OuyangJunyuan/Bus_Adaptor-PCB/BusAdaptor_v2.0/doc/射频参考布线图.jpg

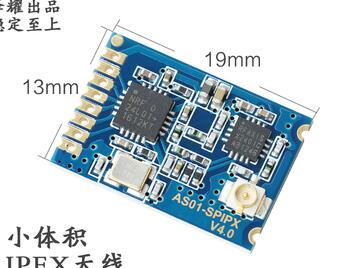
BusAdaptor_v2.0/doc/射频参考布线图.jpg
