OuyangJunyuan/Bus_Adaptor-PCB/BusAdaptor_v2.0/Bus_Adaptor_Sw/backup/pcbpindesign/MDK-ARM/pcbpindesign/pcbpindesign.htm

# Static Call Graph for image pcbpindesign\pcbpindesign.axf

#<CALLGRAPH># ARM Linker, 5060750: Last Updated: Wed Jul 29 13:44:23 2020

### Maximum Stack Usage = 232 bytes + Unknown(Cycles, Untraceable Function Pointers)

### Call chain for Maximum Stack Depth:

OTG_HS_IRQHandler ⇒ HAL_PCD_IRQHandler ⇒ HAL_PCDEx_LPM_Callback ⇒ SystemClock_Config ⇒ HAL_RCC_ClockConfig ⇒ HAL_RCC_GetSysClockFreq ⇒ __aeabi_uldivmod

### Mutually Recursive functions

- ADC_IRQHandler ⇒ ADC_IRQHandler
- BusFault_Handler ⇒ BusFault_Handler
- HardFault_Handler ⇒ HardFault_Handler
- MemManage_Handler ⇒ MemManage_Handler
- UsageFault_Handler ⇒ UsageFault_Handler

### Function Pointers

- ADC_IRQHandler from startup_stm32f765xx.o(.text) referenced from startup_stm32f765xx.o(RESET)
- BusFault_Handler from stm32f7xx_it.o(i.BusFault_Handler) referenced from startup_stm32f765xx.o(RESET)
- CAN1_RX0_IRQHandler from startup_stm32f765xx.o(.text) referenced from startup_stm32f765xx.o(RESET)
- CAN1_RX1_IRQHandler from startup_stm32f765xx.o(.text) referenced from startup_stm32f765xx.o(RESET)
- CAN1_SCE_IRQHandler from startup_stm32f765xx.o(.text) referenced from startup_stm32f765xx.o(RESET)
- CAN1_TX_IRQHandler from startup_stm32f765xx.o(.text) referenced from startup_stm32f765xx.o(RESET)
- CAN2_RX0_IRQHandler from startup_stm32f765xx.o(.text) referenced from startup_stm32f765xx.o(RESET)
- CAN2_RX1_IRQHandler from startup_stm32f765xx.o(.text) referenced from startup_stm32f765xx.o(RESET)
- CAN2_SCE_IRQHandler from startup_stm32f765xx.o(.text) referenced from startup_stm32f765xx.o(RESET)
- CAN2_TX_IRQHandler from startup_stm32f765xx.o(.text) referenced from startup_stm32f765xx.o(RESET)
- CAN3_RX0_IRQHandler from startup_stm32f765xx.o(.text) referenced from startup_stm32f765xx.o(RESET)
- CAN3_RX1_IRQHandler from startup_stm32f765xx.o(.text) referenced from startup_stm32f765xx.o(RESET)
- CAN3_SCE_IRQHandler from startup_stm32f765xx.o(.text) referenced from startup_stm32f765xx.o(RESET)
- CAN3_TX_IRQHandler from startup_stm32f765xx.o(.text) referenced from startup_stm32f765xx.o(RESET)
- CDC_Control_HS from usbd_cdc_if.o(i.CDC_Control_HS) referenced 2 times from usbd_cdc_if.o(.data)
- CDC_DeInit_HS from usbd_cdc_if.o(i.CDC_DeInit_HS) referenced 2 times from usbd_cdc_if.o(.data)
- CDC_Init_HS from usbd_cdc_if.o(i.CDC_Init_HS) referenced 2 times from usbd_cdc_if.o(.data)
- CDC_Receive_HS from usbd_cdc_if.o(i.CDC_Receive_HS) referenced 2 times from usbd_cdc_if.o(.data)
- CDC_TransmitCplt_HS from usbd_cdc_if.o(i.CDC_TransmitCplt_HS) referenced 2 times from usbd_cdc_if.o(.data)
- CEC_IRQHandler from startup_stm32f765xx.o(.text) referenced from startup_stm32f765xx.o(RESET)
- DCMI_IRQHandler from startup_stm32f765xx.o(.text) referenced from startup_stm32f765xx.o(RESET)
- DFSDM1_FLT0_IRQHandler from startup_stm32f765xx.o(.text) referenced from startup_stm32f765xx.o(RESET)
- DFSDM1_FLT1_IRQHandler from startup_stm32f765xx.o(.text) referenced from startup_stm32f765xx.o(RESET)
- DFSDM1_FLT2_IRQHandler from startup_stm32f765xx.o(.text) referenced from startup_stm32f765xx.o(RESET)
- DFSDM1_FLT3_IRQHandler from startup_stm32f765xx.o(.text) referenced from startup_stm32f765xx.o(RESET)
- DMA1_Stream0_IRQHandler from startup_stm32f765xx.o(.text) referenced from startup_stm32f765xx.o(RESET)
- DMA1_Stream1_IRQHandler from startup_stm32f765xx.o(.text) referenced from startup_stm32f765xx.o(RESET)
- DMA1_Stream2_IRQHandler from startup_stm32f765xx.o(.text) referenced from startup_stm32f765xx.o(RESET)
- DMA1_Stream3_IRQHandler from startup_stm32f765xx.o(.text) referenced from startup_stm32f765xx.o(RESET)
- DMA1_Stream4_IRQHandler from startup_stm32f765xx.o(.text) referenced from startup_stm32f765xx.o(RESET)
- DMA1_Stream5_IRQHandler from startup_stm32f765xx.o(.text) referenced from startup_stm32f765xx.o(RESET)
- DMA1_Stream6_IRQHandler from startup_stm32f765xx.o(.text) referenced from startup_stm32f765xx.o(RESET)
- DMA1_Stream7_IRQHandler from startup_stm32f765xx.o(.text) referenced from startup_stm32f765xx.o(RESET)
- DMA2D_IRQHandler from startup_stm32f765xx.o(.text) referenced from startup_stm32f765xx.o(RESET)
- DMA2_Stream0_IRQHandler from startup_stm32f765xx.o(.text) referenced from startup_stm32f765xx.o(RESET)
- DMA2_Stream1_IRQHandler from startup_stm32f765xx.o(.text) referenced from startup_stm32f765xx.o(RESET)
- DMA2_Stream2_IRQHandler from startup_stm32f765xx.o(.text) referenced from startup_stm32f765xx.o(RESET)
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
- TIM8_TRG_COM_TIM14_IRQHandler from startup_stm32f765xx.o(.text) referenced from startup_stm32f765xx.o(RESET)
- TIM8_UP_TIM13_IRQHandler from startup_stm32f765xx.o(.text) referenced from startup_stm32f765xx.o(RESET)
- UART4_IRQHandler from startup_stm32f765xx.o(.text) referenced from startup_stm32f765xx.o(RESET)
- UART5_IRQHandler from startup_stm32f765xx.o(.text) referenced from startup_stm32f765xx.o(RESET)
- UART7_IRQHandler from startup_stm32f765xx.o(.text) referenced from startup_stm32f765xx.o(RESET)
- UART8_IRQHandler from startup_stm32f765xx.o(.text) referenced from startup_stm32f765xx.o(RESET)
- USART1_IRQHandler from startup_stm32f765xx.o(.text) referenced from startup_stm32f765xx.o(RESET)
- USART2_IRQHandler from startup_stm32f765xx.o(.text) referenced from startup_stm32f765xx.o(RESET)
- USART3_IRQHandler from startup_stm32f765xx.o(.text) referenced from startup_stm32f765xx.o(RESET)
- USART6_IRQHandler from startup_stm32f765xx.o(.text) referenced from startup_stm32f765xx.o(RESET)
- USBD_CDC_DataIn from usbd_cdc.o(i.USBD_CDC_DataIn) referenced 2 times from usbd_cdc.o(.data)
- USBD_CDC_DataOut from usbd_cdc.o(i.USBD_CDC_DataOut) referenced 2 times from usbd_cdc.o(.data)
- USBD_CDC_DeInit from usbd_cdc.o(i.USBD_CDC_DeInit) referenced 2 times from usbd_cdc.o(.data)
- USBD_CDC_EP0_RxReady from usbd_cdc.o(i.USBD_CDC_EP0_RxReady) referenced 2 times from usbd_cdc.o(.data)
- USBD_CDC_GetDeviceQualifierDescriptor from usbd_cdc.o(i.USBD_CDC_GetDeviceQualifierDescriptor) referenced 2 times from usbd_cdc.o(.data)
- USBD_CDC_GetFSCfgDesc from usbd_cdc.o(i.USBD_CDC_GetFSCfgDesc) referenced 2 times from usbd_cdc.o(.data)
- USBD_CDC_GetHSCfgDesc from usbd_cdc.o(i.USBD_CDC_GetHSCfgDesc) referenced 2 times from usbd_cdc.o(.data)
- USBD_CDC_GetOtherSpeedCfgDesc from usbd_cdc.o(i.USBD_CDC_GetOtherSpeedCfgDesc) referenced 2 times from usbd_cdc.o(.data)
- USBD_CDC_Init from usbd_cdc.o(i.USBD_CDC_Init) referenced 2 times from usbd_cdc.o(.data)
- USBD_CDC_Setup from usbd_cdc.o(i.USBD_CDC_Setup) referenced 2 times from usbd_cdc.o(.data)
- USBD_HS_ConfigStrDescriptor from usbd_desc.o(i.USBD_HS_ConfigStrDescriptor) referenced 2 times from usbd_desc.o(.data)
- USBD_HS_DeviceDescriptor from usbd_desc.o(i.USBD_HS_DeviceDescriptor) referenced 2 times from usbd_desc.o(.data)
- USBD_HS_InterfaceStrDescriptor from usbd_desc.o(i.USBD_HS_InterfaceStrDescriptor) referenced 2 times from usbd_desc.o(.data)
- USBD_HS_LangIDStrDescriptor from usbd_desc.o(i.USBD_HS_LangIDStrDescriptor) referenced 2 times from usbd_desc.o(.data)
- USBD_HS_ManufacturerStrDescriptor from usbd_desc.o(i.USBD_HS_ManufacturerStrDescriptor) referenced 2 times from usbd_desc.o(.data)
- USBD_HS_ProductStrDescriptor from usbd_desc.o(i.USBD_HS_ProductStrDescriptor) referenced 2 times from usbd_desc.o(.data)
- USBD_HS_SerialStrDescriptor from usbd_desc.o(i.USBD_HS_SerialStrDescriptor) referenced 2 times from usbd_desc.o(.data)
- USBD_HS_USR_BOSDescriptor from usbd_desc.o(i.USBD_HS_USR_BOSDescriptor) referenced 2 times from usbd_desc.o(.data)
- UsageFault_Handler from stm32f7xx_it.o(i.UsageFault_Handler) referenced from startup_stm32f765xx.o(RESET)
- WWDG_IRQHandler from startup_stm32f765xx.o(.text) referenced from startup_stm32f765xx.o(RESET)
- __main from entry.o(.ARM.Collect$$$$00000000) referenced from startup_stm32f765xx.o(.text)
- main from main.o(i.main) referenced from entry9a.o(.ARM.Collect$$$$0000000B)

### Global Symbols

__main (Thumb, 0 bytes, Stack size unknown bytes, entry.o(.ARM.Collect$$$$00000000))
[Address Reference Count : 1]

- startup_stm32f765xx.o(.text)

_main_stk (Thumb, 0 bytes, Stack size unknown bytes, entry2.o(.ARM.Collect$$$$00000001))

_main_scatterload (Thumb, 0 bytes, Stack size unknown bytes, entry5.o(.ARM.Collect$$$$00000004))

[Calls]

- >> __scatterload

__main_after_scatterload (Thumb, 0 bytes, Stack size unknown bytes, entry5.o(.ARM.Collect$$$$00000004))

[Called By]

- >> __scatterload

_main_clock (Thumb, 0 bytes, Stack size unknown bytes, entry7b.o(.ARM.Collect$$$$00000008))

_main_cpp_init (Thumb, 0 bytes, Stack size unknown bytes, entry8b.o(.ARM.Collect$$$$0000000A))

_main_init (Thumb, 0 bytes, Stack size unknown bytes, entry9a.o(.ARM.Collect$$$$0000000B))

__rt_final_cpp (Thumb, 0 bytes, Stack size unknown bytes, entry10a.o(.ARM.Collect$$$$0000000D))

__rt_final_exit (Thumb, 0 bytes, Stack size unknown bytes, entry11a.o(.ARM.Collect$$$$0000000F))

Reset_Handler (Thumb, 8 bytes, Stack size 0 bytes, startup_stm32f765xx.o(.text))
[Address Reference Count : 1]

- startup_stm32f765xx.o(RESET)

ADC_IRQHandler (Thumb, 0 bytes, Stack size 0 bytes, startup_stm32f765xx.o(.text))

[Calls]

- >> ADC_IRQHandler

[Called By]

- >> ADC_IRQHandler

[Address Reference Count : 1]

- startup_stm32f765xx.o(RESET)

CAN1_RX0_IRQHandler (Thumb, 0 bytes, Stack size 0 bytes, startup_stm32f765xx.o(.text))
[Address Reference Count : 1]

- startup_stm32f765xx.o(RESET)

CAN1_RX1_IRQHandler (Thumb, 0 bytes, Stack size 0 bytes, startup_stm32f765xx.o(.text))
[Address Reference Count : 1]

- startup_stm32f765xx.o(RESET)

CAN1_SCE_IRQHandler (Thumb, 0 bytes, Stack size 0 bytes, startup_stm32f765xx.o(.text))
[Address Reference Count : 1]

- startup_stm32f765xx.o(RESET)

CAN1_TX_IRQHandler (Thumb, 0 bytes, Stack size 0 bytes, startup_stm32f765xx.o(.text))
[Address Reference Count : 1]

- startup_stm32f765xx.o(RESET)

CAN2_RX0_IRQHandler (Thumb, 0 bytes, Stack size 0 bytes, startup_stm32f765xx.o(.text))
[Address Reference Count : 1]

- startup_stm32f765xx.o(RESET)

CAN2_RX1_IRQHandler (Thumb, 0 bytes, Stack size 0 bytes, startup_stm32f765xx.o(.text))
[Address Reference Count : 1]

- startup_stm32f765xx.o(RESET)

CAN2_SCE_IRQHandler (Thumb, 0 bytes, Stack size 0 bytes, startup_stm32f765xx.o(.text))
[Address Reference Count : 1]

- startup_stm32f765xx.o(RESET)

CAN2_TX_IRQHandler (Thumb, 0 bytes, Stack size 0 bytes, startup_stm32f765xx.o(.text))
[Address Reference Count : 1]

- startup_stm32f765xx.o(RESET)

CAN3_RX0_IRQHandler (Thumb, 0 bytes, Stack size 0 bytes, startup_stm32f765xx.o(.text))
[Address Reference Count : 1]

- startup_stm32f765xx.o(RESET)

CAN3_RX1_IRQHandler (Thumb, 0 bytes, Stack size 0 bytes, startup_stm32f765xx.o(.text))
[Address Reference Count : 1]

- startup_stm32f765xx.o(RESET)

CAN3_SCE_IRQHandler (Thumb, 0 bytes, Stack size 0 bytes, startup_stm32f765xx.o(.text))
[Address Reference Count : 1]

- startup_stm32f765xx.o(RESET)

CAN3_TX_IRQHandler (Thumb, 0 bytes, Stack size 0 bytes, startup_stm32f765xx.o(.text))
[Address Reference Count : 1]

- startup_stm32f765xx.o(RESET)

CEC_IRQHandler (Thumb, 0 bytes, Stack size 0 bytes, startup_stm32f765xx.o(.text))
[Address Reference Count : 1]

- startup_stm32f765xx.o(RESET)

DCMI_IRQHandler (Thumb, 0 bytes, Stack size 0 bytes, startup_stm32f765xx.o(.text))
[Address Reference Count : 1]

- startup_stm32f765xx.o(RESET)

DFSDM1_FLT0_IRQHandler (Thumb, 0 bytes, Stack size 0 bytes, startup_stm32f765xx.o(.text))
[Address Reference Count : 1]

- startup_stm32f765xx.o(RESET)

DFSDM1_FLT1_IRQHandler (Thumb, 0 bytes, Stack size 0 bytes, startup_stm32f765xx.o(.text))
[Address Reference Count : 1]

- startup_stm32f765xx.o(RESET)

DFSDM1_FLT2_IRQHandler (Thumb, 0 bytes, Stack size 0 bytes, startup_stm32f765xx.o(.text))
[Address Reference Count : 1]

- startup_stm32f765xx.o(RESET)

DFSDM1_FLT3_IRQHandler (Thumb, 0 bytes, Stack size 0 bytes, startup_stm32f765xx.o(.text))
[Address Reference Count : 1]

- startup_stm32f765xx.o(RESET)

DMA1_Stream0_IRQHandler (Thumb, 0 bytes, Stack size 0 bytes, startup_stm32f765xx.o(.text))
[Address Reference Count : 1]

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

TIM4_IRQHandler (Thumb, 0 bytes, Stack size 0 bytes, startup_stm32f765xx.o(.text))
[Address Reference Count : 1]

- startup_stm32f765xx.o(RESET)

TIM5_IRQHandler (Thumb, 0 bytes, Stack size 0 bytes, startup_stm32f765xx.o(.text))
[Address Reference Count : 1]

- startup_stm32f765xx.o(RESET)

TIM6_DAC_IRQHandler (Thumb, 0 bytes, Stack size 0 bytes, startup_stm32f765xx.o(.text))
[Address Reference Count : 1]

- startup_stm32f765xx.o(RESET)

TIM7_IRQHandler (Thumb, 0 bytes, Stack size 0 bytes, startup_stm32f765xx.o(.text))
[Address Reference Count : 1]

- startup_stm32f765xx.o(RESET)

TIM8_BRK_TIM12_IRQHandler (Thumb, 0 bytes, Stack size 0 bytes, startup_stm32f765xx.o(.text))
[Address Reference Count : 1]

- startup_stm32f765xx.o(RESET)

TIM8_CC_IRQHandler (Thumb, 0 bytes, Stack size 0 bytes, startup_stm32f765xx.o(.text))
[Address Reference Count : 1]

- startup_stm32f765xx.o(RESET)

TIM8_TRG_COM_TIM14_IRQHandler (Thumb, 0 bytes, Stack size 0 bytes, startup_stm32f765xx.o(.text))
[Address Reference Count : 1]

- startup_stm32f765xx.o(RESET)

TIM8_UP_TIM13_IRQHandler (Thumb, 0 bytes, Stack size 0 bytes, startup_stm32f765xx.o(.text))
[Address Reference Count : 1]

- startup_stm32f765xx.o(RESET)

UART4_IRQHandler (Thumb, 0 bytes, Stack size 0 bytes, startup_stm32f765xx.o(.text))
[Address Reference Count : 1]

- startup_stm32f765xx.o(RESET)

UART5_IRQHandler (Thumb, 0 bytes, Stack size 0 bytes, startup_stm32f765xx.o(.text))
[Address Reference Count : 1]

- startup_stm32f765xx.o(RESET)

UART7_IRQHandler (Thumb, 0 bytes, Stack size 0 bytes, startup_stm32f765xx.o(.text))
[Address Reference Count : 1]

- startup_stm32f765xx.o(RESET)

UART8_IRQHandler (Thumb, 0 bytes, Stack size 0 bytes, startup_stm32f765xx.o(.text))
[Address Reference Count : 1]

- startup_stm32f765xx.o(RESET)

USART1_IRQHandler (Thumb, 0 bytes, Stack size 0 bytes, startup_stm32f765xx.o(.text))
[Address Reference Count : 1]

- startup_stm32f765xx.o(RESET)

USART2_IRQHandler (Thumb, 0 bytes, Stack size 0 bytes, startup_stm32f765xx.o(.text))
[Address Reference Count : 1]

- startup_stm32f765xx.o(RESET)

USART3_IRQHandler (Thumb, 0 bytes, Stack size 0 bytes, startup_stm32f765xx.o(.text))
[Address Reference Count : 1]

- startup_stm32f765xx.o(RESET)

USART6_IRQHandler (Thumb, 0 bytes, Stack size 0 bytes, startup_stm32f765xx.o(.text))
[Address Reference Count : 1]

- startup_stm32f765xx.o(RESET)

WWDG_IRQHandler (Thumb, 0 bytes, Stack size 0 bytes, startup_stm32f765xx.o(.text))
[Address Reference Count : 1]

- startup_stm32f765xx.o(RESET)

__aeabi_uldivmod (Thumb, 98 bytes, Stack size 40 bytes, uldiv.o(.text))

[Stack]

- Max Depth = 40
- Call Chain = __aeabi_uldivmod

[Calls]

- >> __aeabi_llsr
- >> __aeabi_llsl

[Called By]

- >> HAL_RCC_GetSysClockFreq

__aeabi_memcpy (Thumb, 36 bytes, Stack size 0 bytes, memcpya.o(.text), UNUSED)

__aeabi_memcpy4 (Thumb, 0 bytes, Stack size 0 bytes, memcpya.o(.text))

[Called By]

- >> HAL_PCD_Init

__aeabi_memcpy8 (Thumb, 0 bytes, Stack size 0 bytes, memcpya.o(.text), UNUSED)

__aeabi_memset (Thumb, 14 bytes, Stack size 0 bytes, memseta.o(.text), UNUSED)

[Called By]

- >> _memset$wrapper
- >> __aeabi_memclr

__aeabi_memset4 (Thumb, 0 bytes, Stack size 0 bytes, memseta.o(.text), UNUSED)

__aeabi_memset8 (Thumb, 0 bytes, Stack size 0 bytes, memseta.o(.text), UNUSED)

__aeabi_memclr (Thumb, 4 bytes, Stack size 0 bytes, memseta.o(.text), UNUSED)

[Calls]

- >> __aeabi_memset

__aeabi_memclr4 (Thumb, 0 bytes, Stack size 0 bytes, memseta.o(.text))

[Called By]

- >> HAL_PCD_MspInit
- >> SystemClock_Config

__aeabi_memclr8 (Thumb, 0 bytes, Stack size 0 bytes, memseta.o(.text), UNUSED)

_memset$wrapper (Thumb, 18 bytes, Stack size 8 bytes, memseta.o(.text), UNUSED)

[Calls]

- >> __aeabi_memset

__aeabi_llsl (Thumb, 30 bytes, Stack size 0 bytes, llshl.o(.text))

[Called By]

- >> __aeabi_uldivmod

_ll_shift_l (Thumb, 0 bytes, Stack size 0 bytes, llshl.o(.text), UNUSED)

__aeabi_llsr (Thumb, 32 bytes, Stack size 0 bytes, llushr.o(.text))

[Called By]

- >> __aeabi_uldivmod

_ll_ushift_r (Thumb, 0 bytes, Stack size 0 bytes, llushr.o(.text), UNUSED)

__scatterload (Thumb, 28 bytes, Stack size 0 bytes, init.o(.text))

[Calls]

- >> __main_after_scatterload

[Called By]

- >> _main_scatterload

__scatterload_rt2 (Thumb, 0 bytes, Stack size 0 bytes, init.o(.text), UNUSED)

__decompress (Thumb, 0 bytes, Stack size unknown bytes, __dczerorl2.o(.text), UNUSED)

__decompress1 (Thumb, 86 bytes, Stack size unknown bytes, __dczerorl2.o(.text), UNUSED)

BusFault_Handler (Thumb, 2 bytes, Stack size 0 bytes, stm32f7xx_it.o(i.BusFault_Handler))

[Calls]

- >> BusFault_Handler

[Called By]

- >> BusFault_Handler

[Address Reference Count : 1]

- startup_stm32f765xx.o(RESET)

DebugMon_Handler (Thumb, 2 bytes, Stack size 0 bytes, stm32f7xx_it.o(i.DebugMon_Handler))
[Address Reference Count : 1]

- startup_stm32f765xx.o(RESET)

Error_Handler (Thumb, 2 bytes, Stack size 0 bytes, main.o(i.Error_Handler))

[Called By]

- >> USBD_LL_Init
- >> HAL_PCD_ResetCallback
- >> MX_USB_DEVICE_Init

HAL_Delay (Thumb, 32 bytes, Stack size 16 bytes, stm32f7xx_hal.o(i.HAL_Delay))

[Stack]

- Max Depth = 16
- Call Chain = HAL_Delay

[Calls]

- >> HAL_GetTick

[Called By]

- >> USB_SetCurrentMode
- >> USB_DevDisconnect
- >> USB_DevConnect

HAL_GPIO_Init (Thumb, 420 bytes, Stack size 40 bytes, stm32f7xx_hal_gpio.o(i.HAL_GPIO_Init))

[Stack]

- Max Depth = 40
- Call Chain = HAL_GPIO_Init

[Called By]

- >> HAL_PCD_MspInit

HAL_GetTick (Thumb, 6 bytes, Stack size 0 bytes, stm32f7xx_hal.o(i.HAL_GetTick))

[Called By]

- >> HAL_Delay
- >> HAL_RCC_OscConfig
- >> HAL_RCC_ClockConfig
- >> HAL_PWREx_EnableOverDrive

HAL_IncTick (Thumb, 12 bytes, Stack size 0 bytes, stm32f7xx_hal.o(i.HAL_IncTick))

[Called By]

- >> SysTick_Handler

HAL_Init (Thumb, 22 bytes, Stack size 8 bytes, stm32f7xx_hal.o(i.HAL_Init))

[Stack]

- Max Depth = 40
- Call Chain = HAL_Init ⇒ HAL_InitTick ⇒ HAL_NVIC_SetPriority

[Calls]

- >> HAL_InitTick
- >> HAL_MspInit
- >> HAL_NVIC_SetPriorityGrouping

[Called By]

- >> main

HAL_InitTick (Thumb, 54 bytes, Stack size 16 bytes, stm32f7xx_hal.o(i.HAL_InitTick))

[Stack]

- Max Depth = 32
- Call Chain = HAL_InitTick ⇒ HAL_NVIC_SetPriority

[Calls]

- >> HAL_NVIC_SetPriority
- >> HAL_SYSTICK_Config

[Called By]

- >> HAL_RCC_ClockConfig
- >> HAL_Init

HAL_MspInit (Thumb, 42 bytes, Stack size 8 bytes, stm32f7xx_hal_msp.o(i.HAL_MspInit))

[Stack]

- Max Depth = 8
- Call Chain = HAL_MspInit

[Called By]

- >> HAL_Init

HAL_NVIC_EnableIRQ (Thumb, 26 bytes, Stack size 0 bytes, stm32f7xx_hal_cortex.o(i.HAL_NVIC_EnableIRQ))

[Called By]

- >> HAL_PCD_MspInit

HAL_NVIC_SetPriority (Thumb, 60 bytes, Stack size 16 bytes, stm32f7xx_hal_cortex.o(i.HAL_NVIC_SetPriority))

[Stack]

- Max Depth = 16
- Call Chain = HAL_NVIC_SetPriority

[Calls]

- >> __NVIC_SetPriority

[Called By]

- >> HAL_PCD_MspInit
- >> HAL_InitTick

HAL_NVIC_SetPriorityGrouping (Thumb, 28 bytes, Stack size 8 bytes, stm32f7xx_hal_cortex.o(i.HAL_NVIC_SetPriorityGrouping))

[Stack]

- Max Depth = 8
- Call Chain = HAL_NVIC_SetPriorityGrouping

[Called By]

- >> HAL_Init

HAL_PCDEx_ActivateLPM (Thumb, 34 bytes, Stack size 0 bytes, stm32f7xx_hal_pcd_ex.o(i.HAL_PCDEx_ActivateLPM))

[Called By]

- >> HAL_PCD_Init

HAL_PCDEx_LPM_Callback (Thumb, 92 bytes, Stack size 16 bytes, usbd_conf.o(i.HAL_PCDEx_LPM_Callback))

[Stack]

- Max Depth = 184
- Call Chain = HAL_PCDEx_LPM_Callback ⇒ SystemClock_Config ⇒ HAL_RCC_ClockConfig ⇒ HAL_RCC_GetSysClockFreq ⇒ __aeabi_uldivmod

[Calls]

- >> USBD_LL_Suspend
- >> USBD_LL_Resume
- >> SystemClock_Config

[Called By]

- >> HAL_PCD_IRQHandler

HAL_PCDEx_SetRxFiFo (Thumb, 8 bytes, Stack size 0 bytes, stm32f7xx_hal_pcd_ex.o(i.HAL_PCDEx_SetRxFiFo))

[Called By]

- >> USBD_LL_Init

HAL_PCDEx_SetTxFiFo (Thumb, 70 bytes, Stack size 20 bytes, stm32f7xx_hal_pcd_ex.o(i.HAL_PCDEx_SetTxFiFo))

[Stack]

- Max Depth = 20
- Call Chain = HAL_PCDEx_SetTxFiFo

[Called By]

- >> USBD_LL_Init

HAL_PCD_ConnectCallback (Thumb, 8 bytes, Stack size 0 bytes, usbd_conf.o(i.HAL_PCD_ConnectCallback))

[Calls]

- >> USBD_LL_DevConnected

[Called By]

- >> HAL_PCD_IRQHandler

HAL_PCD_DataInStageCallback (Thumb, 18 bytes, Stack size 0 bytes, usbd_conf.o(i.HAL_PCD_DataInStageCallback))

[Stack]

- Max Depth = 88
- Call Chain = HAL_PCD_DataInStageCallback ⇒ USBD_LL_DataInStage ⇒ USBD_CtlContinueSendData ⇒ USBD_LL_Transmit ⇒ HAL_PCD_EP_Transmit ⇒ USB_EPStartXfer ⇒ USB_WritePacket

[Calls]

- >> USBD_LL_DataInStage

[Called By]

- >> HAL_PCD_IRQHandler

HAL_PCD_DataOutStageCallback (Thumb, 20 bytes, Stack size 0 bytes, usbd_conf.o(i.HAL_PCD_DataOutStageCallback))

[Stack]

- Max Depth = 80
- Call Chain = HAL_PCD_DataOutStageCallback ⇒ USBD_LL_DataOutStage ⇒ USBD_CtlSendStatus ⇒ USBD_LL_Transmit ⇒ HAL_PCD_EP_Transmit ⇒ USB_EPStartXfer ⇒ USB_WritePacket

[Calls]

- >> USBD_LL_DataOutStage

[Called By]

- >> PCD_EP_OutXfrComplete_int

HAL_PCD_DisconnectCallback (Thumb, 8 bytes, Stack size 0 bytes, usbd_conf.o(i.HAL_PCD_DisconnectCallback))

[Stack]

- Max Depth = 8
- Call Chain = HAL_PCD_DisconnectCallback ⇒ USBD_LL_DevDisconnected

[Calls]

- >> USBD_LL_DevDisconnected

[Called By]

- >> HAL_PCD_IRQHandler

HAL_PCD_EP_Close (Thumb, 76 bytes, Stack size 16 bytes, stm32f7xx_hal_pcd.o(i.HAL_PCD_EP_Close))

[Stack]

- Max Depth = 32
- Call Chain = HAL_PCD_EP_Close ⇒ USB_DeactivateEndpoint

[Calls]

- >> USB_DeactivateEndpoint

[Called By]

- >> USBD_LL_CloseEP

HAL_PCD_EP_ClrStall (Thumb, 92 bytes, Stack size 16 bytes, stm32f7xx_hal_pcd.o(i.HAL_PCD_EP_ClrStall))

[Stack]

- Max Depth = 16
- Call Chain = HAL_PCD_EP_ClrStall

[Calls]

- >> USB_EPClearStall

[Called By]

- >> USBD_LL_ClearStallEP

HAL_PCD_EP_GetRxCount (Thumb, 18 bytes, Stack size 0 bytes, stm32f7xx_hal_pcd.o(i.HAL_PCD_EP_GetRxCount))

[Called By]

- >> USBD_LL_GetRxDataSize

HAL_PCD_EP_Open (Thumb, 96 bytes, Stack size 24 bytes, stm32f7xx_hal_pcd.o(i.HAL_PCD_EP_Open))

[Stack]

- Max Depth = 40
- Call Chain = HAL_PCD_EP_Open ⇒ USB_ActivateEndpoint

[Calls]

- >> USB_ActivateEndpoint

[Called By]

- >> USBD_LL_OpenEP

HAL_PCD_EP_Receive (Thumb, 68 bytes, Stack size 16 bytes, stm32f7xx_hal_pcd.o(i.HAL_PCD_EP_Receive))

[Stack]

- Max Depth = 48
- Call Chain = HAL_PCD_EP_Receive ⇒ USB_EPStartXfer ⇒ USB_WritePacket

[Calls]

- >> USB_EPStartXfer
- >> USB_EP0StartXfer

[Called By]

- >> USBD_LL_PrepareReceive

HAL_PCD_EP_SetStall (Thumb, 116 bytes, Stack size 16 bytes, stm32f7xx_hal_pcd.o(i.HAL_PCD_EP_SetStall))

[Stack]

- Max Depth = 24
- Call Chain = HAL_PCD_EP_SetStall ⇒ USB_EP0_OutStart

[Calls]

- >> USB_EPSetStall
- >> USB_EP0_OutStart

[Called By]

- >> USBD_LL_StallEP

HAL_PCD_EP_Transmit (Thumb, 68 bytes, Stack size 24 bytes, stm32f7xx_hal_pcd.o(i.HAL_PCD_EP_Transmit))

[Stack]

- Max Depth = 56
- Call Chain = HAL_PCD_EP_Transmit ⇒ USB_EPStartXfer ⇒ USB_WritePacket

[Calls]

- >> USB_EPStartXfer
- >> USB_EP0StartXfer

[Called By]

- >> USBD_LL_Transmit

HAL_PCD_IRQHandler (Thumb, 1134 bytes, Stack size 48 bytes, stm32f7xx_hal_pcd.o(i.HAL_PCD_IRQHandler))

[Stack]

- Max Depth = 232
- Call Chain = HAL_PCD_IRQHandler ⇒ HAL_PCDEx_LPM_Callback ⇒ SystemClock_Config ⇒ HAL_RCC_ClockConfig ⇒ HAL_RCC_GetSysClockFreq ⇒ __aeabi_uldivmod

[Calls]

- >> HAL_PCD_SuspendCallback
- >> HAL_PCD_SetupStageCallback
- >> HAL_PCD_SOFCallback
- >> HAL_PCD_ResumeCallback
- >> HAL_PCD_ResetCallback
- >> HAL_PCD_ISOOUTIncompleteCallback
- >> HAL_PCD_ISOINIncompleteCallback
- >> HAL_PCD_DisconnectCallback
- >> HAL_PCD_DataInStageCallback
- >> HAL_PCD_ConnectCallback
- >> HAL_PCDEx_LPM_Callback
- >> USB_SetTurnaroundTime
- >> USB_ReadPacket
- >> USB_ReadInterrupts
- >> USB_ReadDevOutEPInterrupt
- >> USB_ReadDevInEPInterrupt
- >> USB_ReadDevAllOutEpInterrupt
- >> USB_ReadDevAllInEpInterrupt
- >> USB_GetMode
- >> USB_GetDevSpeed
- >> USB_FlushTxFifo
- >> USB_EP0_OutStart
- >> USB_ActivateSetup
- >> HAL_RCC_GetHCLKFreq
- >> PCD_WriteEmptyTxFifo
- >> PCD_EP_OutXfrComplete_int

[Called By]

- >> OTG_HS_IRQHandler

HAL_PCD_ISOINIncompleteCallback (Thumb, 8 bytes, Stack size 0 bytes, usbd_conf.o(i.HAL_PCD_ISOINIncompleteCallback))

[Calls]

- >> USBD_LL_IsoINIncomplete

[Called By]

- >> HAL_PCD_IRQHandler

HAL_PCD_ISOOUTIncompleteCallback (Thumb, 8 bytes, Stack size 0 bytes, usbd_conf.o(i.HAL_PCD_ISOOUTIncompleteCallback))

[Calls]

- >> USBD_LL_IsoOUTIncomplete

[Called By]

- >> HAL_PCD_IRQHandler

HAL_PCD_Init (Thumb, 242 bytes, Stack size 64 bytes, stm32f7xx_hal_pcd.o(i.HAL_PCD_Init))

[Stack]

- Max Depth = 152
- Call Chain = HAL_PCD_Init ⇒ HAL_PCD_MspInit ⇒ HAL_GPIO_Init

[Calls]

- >> HAL_PCD_MspInit
- >> __aeabi_memcpy4
- >> USB_SetCurrentMode
- >> USB_DisableGlobalInt
- >> USB_DevInit
- >> USB_DevDisconnect
- >> USB_CoreInit
- >> HAL_PCDEx_ActivateLPM

[Called By]

- >> USBD_LL_Init

HAL_PCD_MspInit (Thumb, 182 bytes, Stack size 48 bytes, usbd_conf.o(i.HAL_PCD_MspInit))

[Stack]

- Max Depth = 88
- Call Chain = HAL_PCD_MspInit ⇒ HAL_GPIO_Init

[Calls]

- >> HAL_NVIC_SetPriority
- >> HAL_NVIC_EnableIRQ
- >> HAL_GPIO_Init
- >> __aeabi_memclr4

[Called By]

- >> HAL_PCD_Init

HAL_PCD_ResetCallback (Thumb, 44 bytes, Stack size 16 bytes, usbd_conf.o(i.HAL_PCD_ResetCallback))

[Stack]

- Max Depth = 80
- Call Chain = HAL_PCD_ResetCallback ⇒ USBD_LL_Reset ⇒ USBD_LL_OpenEP ⇒ HAL_PCD_EP_Open ⇒ USB_ActivateEndpoint

[Calls]

- >> USBD_LL_SetSpeed
- >> USBD_LL_Reset
- >> Error_Handler

[Called By]

- >> HAL_PCD_IRQHandler

HAL_PCD_ResumeCallback (Thumb, 8 bytes, Stack size 0 bytes, usbd_conf.o(i.HAL_PCD_ResumeCallback))

[Calls]

- >> USBD_LL_Resume

[Called By]

- >> HAL_PCD_IRQHandler

HAL_PCD_SOFCallback (Thumb, 8 bytes, Stack size 0 bytes, usbd_conf.o(i.HAL_PCD_SOFCallback))

[Stack]

- Max Depth = 8
- Call Chain = HAL_PCD_SOFCallback ⇒ USBD_LL_SOF

[Calls]

- >> USBD_LL_SOF

[Called By]

- >> HAL_PCD_IRQHandler

HAL_PCD_SetAddress (Thumb, 40 bytes, Stack size 8 bytes, stm32f7xx_hal_pcd.o(i.HAL_PCD_SetAddress))

[Stack]

- Max Depth = 8
- Call Chain = HAL_PCD_SetAddress

[Calls]

- >> USB_SetDevAddress

[Called By]

- >> USBD_LL_SetUSBAddress

HAL_PCD_SetupStageCallback (Thumb, 14 bytes, Stack size 0 bytes, usbd_conf.o(i.HAL_PCD_SetupStageCallback))

[Stack]

- Max Depth = 136
- Call Chain = HAL_PCD_SetupStageCallback ⇒ USBD_LL_SetupStage ⇒ USBD_StdDevReq ⇒ USBD_SetConfig ⇒ USBD_CtlSendStatus ⇒ USBD_LL_Transmit ⇒ HAL_PCD_EP_Transmit ⇒ USB_EPStartXfer ⇒ USB_WritePacket

[Calls]

- >> USBD_LL_SetupStage

[Called By]

- >> HAL_PCD_IRQHandler

HAL_PCD_Start (Thumb, 42 bytes, Stack size 8 bytes, stm32f7xx_hal_pcd.o(i.HAL_PCD_Start))

[Stack]

- Max Depth = 32
- Call Chain = HAL_PCD_Start ⇒ USB_DevConnect ⇒ HAL_Delay

[Calls]

- >> USB_EnableGlobalInt
- >> USB_DevConnect

[Called By]

- >> USBD_LL_Start

HAL_PCD_SuspendCallback (Thumb, 44 bytes, Stack size 8 bytes, usbd_conf.o(i.HAL_PCD_SuspendCallback))

[Stack]

- Max Depth = 8
- Call Chain = HAL_PCD_SuspendCallback

[Calls]

- >> USBD_LL_Suspend

[Called By]

- >> HAL_PCD_IRQHandler

HAL_PWREx_EnableOverDrive (Thumb, 100 bytes, Stack size 24 bytes, stm32f7xx_hal_pwr_ex.o(i.HAL_PWREx_EnableOverDrive))

[Stack]

- Max Depth = 24
- Call Chain = HAL_PWREx_EnableOverDrive

[Calls]

- >> HAL_GetTick

[Called By]

- >> SystemClock_Config

HAL_RCC_ClockConfig (Thumb, 284 bytes, Stack size 32 bytes, stm32f7xx_hal_rcc.o(i.HAL_RCC_ClockConfig))

[Stack]

- Max Depth = 80
- Call Chain = HAL_RCC_ClockConfig ⇒ HAL_RCC_GetSysClockFreq ⇒ __aeabi_uldivmod

[Calls]

- >> HAL_InitTick
- >> HAL_GetTick
- >> HAL_RCC_GetSysClockFreq

[Called By]

- >> SystemClock_Config

HAL_RCC_GetHCLKFreq (Thumb, 6 bytes, Stack size 0 bytes, stm32f7xx_hal_rcc.o(i.HAL_RCC_GetHCLKFreq))

[Called By]

- >> HAL_PCD_IRQHandler

HAL_RCC_GetSysClockFreq (Thumb, 88 bytes, Stack size 8 bytes, stm32f7xx_hal_rcc.o(i.HAL_RCC_GetSysClockFreq))

[Stack]

- Max Depth = 48
- Call Chain = HAL_RCC_GetSysClockFreq ⇒ __aeabi_uldivmod

[Calls]

- >> __aeabi_uldivmod

[Called By]

- >> HAL_RCC_ClockConfig

HAL_RCC_OscConfig (Thumb, 906 bytes, Stack size 40 bytes, stm32f7xx_hal_rcc.o(i.HAL_RCC_OscConfig))

[Stack]

- Max Depth = 40
- Call Chain = HAL_RCC_OscConfig

[Calls]

- >> HAL_GetTick

[Called By]

- >> SystemClock_Config

HAL_SYSTICK_Config (Thumb, 38 bytes, Stack size 8 bytes, stm32f7xx_hal_cortex.o(i.HAL_SYSTICK_Config))

[Stack]

- Max Depth = 8
- Call Chain = HAL_SYSTICK_Config

[Calls]

- >> __NVIC_SetPriority

[Called By]

- >> HAL_InitTick

HardFault_Handler (Thumb, 2 bytes, Stack size 0 bytes, stm32f7xx_it.o(i.HardFault_Handler))

[Calls]

- >> HardFault_Handler

[Called By]

- >> HardFault_Handler

[Address Reference Count : 1]

- startup_stm32f765xx.o(RESET)

MX_GPIO_Init (Thumb, 70 bytes, Stack size 8 bytes, gpio.o(i.MX_GPIO_Init))

[Stack]

- Max Depth = 8
- Call Chain = MX_GPIO_Init

[Called By]

- >> main

MX_USB_DEVICE_Init (Thumb, 66 bytes, Stack size 8 bytes, usb_device.o(i.MX_USB_DEVICE_Init))

[Stack]

- Max Depth = 184
- Call Chain = MX_USB_DEVICE_Init ⇒ USBD_Init ⇒ USBD_LL_Init ⇒ HAL_PCD_Init ⇒ HAL_PCD_MspInit ⇒ HAL_GPIO_Init

[Calls]

- >> USBD_Start
- >> USBD_RegisterClass
- >> USBD_Init
- >> USBD_CDC_RegisterInterface
- >> Error_Handler

[Called By]

- >> main

MemManage_Handler (Thumb, 2 bytes, Stack size 0 bytes, stm32f7xx_it.o(i.MemManage_Handler))

[Calls]

- >> MemManage_Handler

[Called By]

- >> MemManage_Handler

[Address Reference Count : 1]

- startup_stm32f765xx.o(RESET)

NMI_Handler (Thumb, 2 bytes, Stack size 0 bytes, stm32f7xx_it.o(i.NMI_Handler))
[Address Reference Count : 1]

- startup_stm32f765xx.o(RESET)

OTG_HS_IRQHandler (Thumb, 6 bytes, Stack size 0 bytes, stm32f7xx_it.o(i.OTG_HS_IRQHandler))

[Stack]

- Max Depth = 232
- Call Chain = OTG_HS_IRQHandler ⇒ HAL_PCD_IRQHandler ⇒ HAL_PCDEx_LPM_Callback ⇒ SystemClock_Config ⇒ HAL_RCC_ClockConfig ⇒ HAL_RCC_GetSysClockFreq ⇒ __aeabi_uldivmod

[Calls]

- >> HAL_PCD_IRQHandler

[Address Reference Count : 1]

- startup_stm32f765xx.o(RESET)

PendSV_Handler (Thumb, 2 bytes, Stack size 0 bytes, stm32f7xx_it.o(i.PendSV_Handler))
[Address Reference Count : 1]

- startup_stm32f765xx.o(RESET)

SVC_Handler (Thumb, 2 bytes, Stack size 0 bytes, stm32f7xx_it.o(i.SVC_Handler))
[Address Reference Count : 1]

- startup_stm32f765xx.o(RESET)

SysTick_Handler (Thumb, 4 bytes, Stack size 0 bytes, stm32f7xx_it.o(i.SysTick_Handler))

[Calls]

- >> HAL_IncTick

[Address Reference Count : 1]

- startup_stm32f765xx.o(RESET)

SystemClock_Config (Thumb, 128 bytes, Stack size 88 bytes, main.o(i.SystemClock_Config))

[Stack]

- Max Depth = 168
- Call Chain = SystemClock_Config ⇒ HAL_RCC_ClockConfig ⇒ HAL_RCC_GetSysClockFreq ⇒ __aeabi_uldivmod

[Calls]

- >> HAL_RCC_OscConfig
- >> HAL_RCC_ClockConfig
- >> HAL_PWREx_EnableOverDrive
- >> __aeabi_memclr4

[Called By]

- >> HAL_PCDEx_LPM_Callback
- >> main

SystemInit (Thumb, 22 bytes, Stack size 0 bytes, system_stm32f7xx.o(i.SystemInit))
[Address Reference Count : 1]

- startup_stm32f765xx.o(.text)

USBD_CDC_GetDeviceQualifierDescriptor (Thumb, 8 bytes, Stack size 0 bytes, usbd_cdc.o(i.USBD_CDC_GetDeviceQualifierDescriptor))
[Address Reference Count : 1]

- usbd_cdc.o(.data)

USBD_CDC_ReceivePacket (Thumb, 40 bytes, Stack size 8 bytes, usbd_cdc.o(i.USBD_CDC_ReceivePacket))

[Stack]

- Max Depth = 64
- Call Chain = USBD_CDC_ReceivePacket ⇒ USBD_LL_PrepareReceive ⇒ HAL_PCD_EP_Receive ⇒ USB_EPStartXfer ⇒ USB_WritePacket

[Calls]

- >> USBD_LL_PrepareReceive

[Called By]

- >> CDC_Receive_HS

USBD_CDC_RegisterInterface (Thumb, 14 bytes, Stack size 0 bytes, usbd_cdc.o(i.USBD_CDC_RegisterInterface))

[Called By]

- >> MX_USB_DEVICE_Init

USBD_CDC_SetRxBuffer (Thumb, 12 bytes, Stack size 0 bytes, usbd_cdc.o(i.USBD_CDC_SetRxBuffer))

[Called By]

- >> CDC_Receive_HS
- >> CDC_Init_HS

USBD_CDC_SetTxBuffer (Thumb, 16 bytes, Stack size 0 bytes, usbd_cdc.o(i.USBD_CDC_SetTxBuffer))

[Called By]

- >> CDC_Init_HS

USBD_ClrClassConfig (Thumb, 16 bytes, Stack size 8 bytes, usbd_core.o(i.USBD_ClrClassConfig))

[Stack]

- Max Depth = 8
- Call Chain = USBD_ClrClassConfig

[Called By]

- >> USBD_SetConfig

USBD_CtlContinueRx (Thumb, 16 bytes, Stack size 8 bytes, usbd_ioreq.o(i.USBD_CtlContinueRx))

[Stack]

- Max Depth = 64
- Call Chain = USBD_CtlContinueRx ⇒ USBD_LL_PrepareReceive ⇒ HAL_PCD_EP_Receive ⇒ USB_EPStartXfer ⇒ USB_WritePacket

[Calls]

- >> USBD_LL_PrepareReceive

[Called By]

- >> USBD_LL_DataOutStage

USBD_CtlContinueSendData (Thumb, 16 bytes, Stack size 8 bytes, usbd_ioreq.o(i.USBD_CtlContinueSendData))

[Stack]

- Max Depth = 72
- Call Chain = USBD_CtlContinueSendData ⇒ USBD_LL_Transmit ⇒ HAL_PCD_EP_Transmit ⇒ USB_EPStartXfer ⇒ USB_WritePacket

[Calls]

- >> USBD_LL_Transmit

[Called By]

- >> USBD_LL_DataInStage

USBD_CtlError (Thumb, 22 bytes, Stack size 8 bytes, usbd_ctlreq.o(i.USBD_CtlError))

[Stack]

- Max Depth = 40
- Call Chain = USBD_CtlError ⇒ USBD_LL_StallEP ⇒ HAL_PCD_EP_SetStall ⇒ USB_EP0_OutStart

[Calls]

- >> USBD_LL_StallEP

[Called By]

- >> USBD_CDC_Setup
- >> USBD_SetConfig
- >> USBD_GetDescriptor
- >> USBD_StdItfReq
- >> USBD_StdEPReq
- >> USBD_StdDevReq

USBD_CtlPrepareRx (Thumb, 30 bytes, Stack size 8 bytes, usbd_ioreq.o(i.USBD_CtlPrepareRx))

[Stack]

- Max Depth = 64
- Call Chain = USBD_CtlPrepareRx ⇒ USBD_LL_PrepareReceive ⇒ HAL_PCD_EP_Receive ⇒ USB_EPStartXfer ⇒ USB_WritePacket

[Calls]

- >> USBD_LL_PrepareReceive

[Called By]

- >> USBD_CDC_Setup

USBD_CtlReceiveStatus (Thumb, 22 bytes, Stack size 8 bytes, usbd_ioreq.o(i.USBD_CtlReceiveStatus))

[Stack]

- Max Depth = 64
- Call Chain = USBD_CtlReceiveStatus ⇒ USBD_LL_PrepareReceive ⇒ HAL_PCD_EP_Receive ⇒ USB_EPStartXfer ⇒ USB_WritePacket

[Calls]

- >> USBD_LL_PrepareReceive

[Called By]

- >> USBD_LL_DataInStage

USBD_CtlSendData (Thumb, 26 bytes, Stack size 8 bytes, usbd_ioreq.o(i.USBD_CtlSendData))

[Stack]

- Max Depth = 72
- Call Chain = USBD_CtlSendData ⇒ USBD_LL_Transmit ⇒ HAL_PCD_EP_Transmit ⇒ USB_EPStartXfer ⇒ USB_WritePacket

[Calls]

- >> USBD_LL_Transmit

[Called By]

- >> USBD_CDC_Setup
- >> USBD_GetDescriptor
- >> USBD_StdEPReq
- >> USBD_StdDevReq

USBD_CtlSendStatus (Thumb, 22 bytes, Stack size 8 bytes, usbd_ioreq.o(i.USBD_CtlSendStatus))

[Stack]

- Max Depth = 72
- Call Chain = USBD_CtlSendStatus ⇒ USBD_LL_Transmit ⇒ HAL_PCD_EP_Transmit ⇒ USB_EPStartXfer ⇒ USB_WritePacket

[Calls]

- >> USBD_LL_Transmit

[Called By]

- >> USBD_LL_DataOutStage
- >> USBD_SetConfig
- >> USBD_GetDescriptor
- >> USBD_StdItfReq
- >> USBD_StdEPReq
- >> USBD_StdDevReq

USBD_GetString (Thumb, 74 bytes, Stack size 16 bytes, usbd_ctlreq.o(i.USBD_GetString))

[Stack]

- Max Depth = 16
- Call Chain = USBD_GetString

[Called By]

- >> USBD_HS_ProductStrDescriptor
- >> USBD_HS_ManufacturerStrDescriptor
- >> USBD_HS_InterfaceStrDescriptor
- >> USBD_HS_ConfigStrDescriptor

USBD_Get_USB_Status (Thumb, 24 bytes, Stack size 0 bytes, usbd_conf.o(i.USBD_Get_USB_Status))

[Called By]

- >> USBD_LL_Transmit
- >> USBD_LL_Start
- >> USBD_LL_StallEP
- >> USBD_LL_SetUSBAddress
- >> USBD_LL_PrepareReceive
- >> USBD_LL_OpenEP
- >> USBD_LL_CloseEP
- >> USBD_LL_ClearStallEP

USBD_HS_ConfigStrDescriptor (Thumb, 16 bytes, Stack size 8 bytes, usbd_desc.o(i.USBD_HS_ConfigStrDescriptor))

[Stack]

- Max Depth = 24
- Call Chain = USBD_HS_ConfigStrDescriptor ⇒ USBD_GetString

[Calls]

- >> USBD_GetString

[Address Reference Count : 1]

- usbd_desc.o(.data)

USBD_HS_DeviceDescriptor (Thumb, 8 bytes, Stack size 0 bytes, usbd_desc.o(i.USBD_HS_DeviceDescriptor))
[Address Reference Count : 1]

- usbd_desc.o(.data)

USBD_HS_InterfaceStrDescriptor (Thumb, 16 bytes, Stack size 8 bytes, usbd_desc.o(i.USBD_HS_InterfaceStrDescriptor))

[Stack]

- Max Depth = 24
- Call Chain = USBD_HS_InterfaceStrDescriptor ⇒ USBD_GetString

[Calls]

- >> USBD_GetString

[Address Reference Count : 1]

- usbd_desc.o(.data)

USBD_HS_LangIDStrDescriptor (Thumb, 8 bytes, Stack size 0 bytes, usbd_desc.o(i.USBD_HS_LangIDStrDescriptor))
[Address Reference Count : 1]

- usbd_desc.o(.data)

USBD_HS_ManufacturerStrDescriptor (Thumb, 16 bytes, Stack size 8 bytes, usbd_desc.o(i.USBD_HS_ManufacturerStrDescriptor))

[Stack]

- Max Depth = 24
- Call Chain = USBD_HS_ManufacturerStrDescriptor ⇒ USBD_GetString

[Calls]

- >> USBD_GetString

[Address Reference Count : 1]

- usbd_desc.o(.data)

USBD_HS_ProductStrDescriptor (Thumb, 16 bytes, Stack size 8 bytes, usbd_desc.o(i.USBD_HS_ProductStrDescriptor))

[Stack]

- Max Depth = 24
- Call Chain = USBD_HS_ProductStrDescriptor ⇒ USBD_GetString

[Calls]

- >> USBD_GetString

[Address Reference Count : 1]

- usbd_desc.o(.data)

USBD_HS_SerialStrDescriptor (Thumb, 50 bytes, Stack size 8 bytes, usbd_desc.o(i.USBD_HS_SerialStrDescriptor))

[Stack]

- Max Depth = 28
- Call Chain = USBD_HS_SerialStrDescriptor ⇒ IntToUnicode

[Calls]

- >> IntToUnicode

[Address Reference Count : 1]

- usbd_desc.o(.data)

USBD_HS_USR_BOSDescriptor (Thumb, 8 bytes, Stack size 0 bytes, usbd_desc.o(i.USBD_HS_USR_BOSDescriptor))
[Address Reference Count : 1]

- usbd_desc.o(.data)

USBD_Init (Thumb, 52 bytes, Stack size 8 bytes, usbd_core.o(i.USBD_Init))

[Stack]

- Max Depth = 176
- Call Chain = USBD_Init ⇒ USBD_LL_Init ⇒ HAL_PCD_Init ⇒ HAL_PCD_MspInit ⇒ HAL_GPIO_Init

[Calls]

- >> USBD_LL_Init

[Called By]

- >> MX_USB_DEVICE_Init

USBD_LL_ClearStallEP (Thumb, 18 bytes, Stack size 8 bytes, usbd_conf.o(i.USBD_LL_ClearStallEP))

[Stack]

- Max Depth = 24
- Call Chain = USBD_LL_ClearStallEP ⇒ HAL_PCD_EP_ClrStall

[Calls]

- >> HAL_PCD_EP_ClrStall
- >> USBD_Get_USB_Status

[Called By]

- >> USBD_StdEPReq

USBD_LL_CloseEP (Thumb, 18 bytes, Stack size 8 bytes, usbd_conf.o(i.USBD_LL_CloseEP))

[Stack]

- Max Depth = 40
- Call Chain = USBD_LL_CloseEP ⇒ HAL_PCD_EP_Close ⇒ USB_DeactivateEndpoint

[Calls]

- >> HAL_PCD_EP_Close
- >> USBD_Get_USB_Status

[Called By]

- >> USBD_CDC_DeInit

USBD_LL_DataInStage (Thumb, 170 bytes, Stack size 16 bytes, usbd_core.o(i.USBD_LL_DataInStage))

[Stack]

- Max Depth = 88
- Call Chain = USBD_LL_DataInStage ⇒ USBD_CtlContinueSendData ⇒ USBD_LL_Transmit ⇒ HAL_PCD_EP_Transmit ⇒ USB_EPStartXfer ⇒ USB_WritePacket

[Calls]

- >> USBD_LL_StallEP
- >> USBD_LL_PrepareReceive
- >> USBD_CtlReceiveStatus
- >> USBD_CtlContinueSendData

[Called By]

- >> HAL_PCD_DataInStageCallback

USBD_LL_DataOutStage (Thumb, 110 bytes, Stack size 8 bytes, usbd_core.o(i.USBD_LL_DataOutStage))

[Stack]

- Max Depth = 80
- Call Chain = USBD_LL_DataOutStage ⇒ USBD_CtlSendStatus ⇒ USBD_LL_Transmit ⇒ HAL_PCD_EP_Transmit ⇒ USB_EPStartXfer ⇒ USB_WritePacket

[Calls]

- >> USBD_CtlSendStatus
- >> USBD_CtlContinueRx

[Called By]

- >> HAL_PCD_DataOutStageCallback

USBD_LL_DevConnected (Thumb, 4 bytes, Stack size 0 bytes, usbd_core.o(i.USBD_LL_DevConnected))

[Called By]

- >> HAL_PCD_ConnectCallback

USBD_LL_DevDisconnected (Thumb, 26 bytes, Stack size 8 bytes, usbd_core.o(i.USBD_LL_DevDisconnected))

[Stack]

- Max Depth = 8
- Call Chain = USBD_LL_DevDisconnected

[Called By]

- >> HAL_PCD_DisconnectCallback

USBD_LL_GetRxDataSize (Thumb, 8 bytes, Stack size 0 bytes, usbd_conf.o(i.USBD_LL_GetRxDataSize))

[Calls]

- >> HAL_PCD_EP_GetRxCount

[Called By]

- >> USBD_CDC_DataOut

USBD_LL_Init (Thumb, 96 bytes, Stack size 16 bytes, usbd_conf.o(i.USBD_LL_Init))

[Stack]

- Max Depth = 168
- Call Chain = USBD_LL_Init ⇒ HAL_PCD_Init ⇒ HAL_PCD_MspInit ⇒ HAL_GPIO_Init

[Calls]

- >> HAL_PCD_Init
- >> HAL_PCDEx_SetTxFiFo
- >> HAL_PCDEx_SetRxFiFo
- >> Error_Handler

[Called By]

- >> USBD_Init

USBD_LL_IsStallEP (Thumb, 32 bytes, Stack size 0 bytes, usbd_conf.o(i.USBD_LL_IsStallEP))

[Called By]

- >> USBD_StdEPReq

USBD_LL_IsoINIncomplete (Thumb, 4 bytes, Stack size 0 bytes, usbd_core.o(i.USBD_LL_IsoINIncomplete))

[Called By]

- >> HAL_PCD_ISOINIncompleteCallback

USBD_LL_IsoOUTIncomplete (Thumb, 4 bytes, Stack size 0 bytes, usbd_core.o(i.USBD_LL_IsoOUTIncomplete))

[Called By]

- >> HAL_PCD_ISOOUTIncompleteCallback

USBD_LL_OpenEP (Thumb, 24 bytes, Stack size 8 bytes, usbd_conf.o(i.USBD_LL_OpenEP))

[Stack]

- Max Depth = 48
- Call Chain = USBD_LL_OpenEP ⇒ HAL_PCD_EP_Open ⇒ USB_ActivateEndpoint

[Calls]

- >> HAL_PCD_EP_Open
- >> USBD_Get_USB_Status

[Called By]

- >> USBD_LL_Reset
- >> USBD_CDC_Init

USBD_LL_PrepareReceive (Thumb, 18 bytes, Stack size 8 bytes, usbd_conf.o(i.USBD_LL_PrepareReceive))

[Stack]

- Max Depth = 56
- Call Chain = USBD_LL_PrepareReceive ⇒ HAL_PCD_EP_Receive ⇒ USB_EPStartXfer ⇒ USB_WritePacket

[Calls]

- >> HAL_PCD_EP_Receive
- >> USBD_Get_USB_Status

[Called By]

- >> USBD_CDC_ReceivePacket
- >> USBD_LL_DataInStage
- >> USBD_CDC_Init
- >> USBD_CtlPrepareRx
- >> USBD_CtlReceiveStatus
- >> USBD_CtlContinueRx

USBD_LL_Reset (Thumb, 82 bytes, Stack size 16 bytes, usbd_core.o(i.USBD_LL_Reset))

[Stack]

- Max Depth = 64
- Call Chain = USBD_LL_Reset ⇒ USBD_LL_OpenEP ⇒ HAL_PCD_EP_Open ⇒ USB_ActivateEndpoint

[Calls]

- >> USBD_LL_OpenEP

[Called By]

- >> HAL_PCD_ResetCallback

USBD_LL_Resume (Thumb, 20 bytes, Stack size 0 bytes, usbd_core.o(i.USBD_LL_Resume))

[Called By]

- >> HAL_PCD_ResumeCallback
- >> HAL_PCDEx_LPM_Callback

USBD_LL_SOF (Thumb, 24 bytes, Stack size 8 bytes, usbd_core.o(i.USBD_LL_SOF))

[Stack]

- Max Depth = 8
- Call Chain = USBD_LL_SOF

[Called By]

- >> HAL_PCD_SOFCallback

USBD_LL_SetSpeed (Thumb, 6 bytes, Stack size 0 bytes, usbd_core.o(i.USBD_LL_SetSpeed))

[Called By]

- >> HAL_PCD_ResetCallback

USBD_LL_SetUSBAddress (Thumb, 18 bytes, Stack size 8 bytes, usbd_conf.o(i.USBD_LL_SetUSBAddress))

[Stack]

- Max Depth = 16
- Call Chain = USBD_LL_SetUSBAddress ⇒ HAL_PCD_SetAddress

[Calls]

- >> HAL_PCD_SetAddress
- >> USBD_Get_USB_Status

[Called By]

- >> USBD_StdDevReq

USBD_LL_SetupStage (Thumb, 92 bytes, Stack size 16 bytes, usbd_core.o(i.USBD_LL_SetupStage))

[Stack]

- Max Depth = 136
- Call Chain = USBD_LL_SetupStage ⇒ USBD_StdDevReq ⇒ USBD_SetConfig ⇒ USBD_CtlSendStatus ⇒ USBD_LL_Transmit ⇒ HAL_PCD_EP_Transmit ⇒ USB_EPStartXfer ⇒ USB_WritePacket

[Calls]

- >> USBD_LL_StallEP
- >> USBD_StdItfReq
- >> USBD_StdEPReq
- >> USBD_StdDevReq
- >> USBD_ParseSetupRequest

[Called By]

- >> HAL_PCD_SetupStageCallback

USBD_LL_StallEP (Thumb, 18 bytes, Stack size 8 bytes, usbd_conf.o(i.USBD_LL_StallEP))

[Stack]

- Max Depth = 32
- Call Chain = USBD_LL_StallEP ⇒ HAL_PCD_EP_SetStall ⇒ USB_EP0_OutStart

[Calls]

- >> HAL_PCD_EP_SetStall
- >> USBD_Get_USB_Status

[Called By]

- >> USBD_LL_SetupStage
- >> USBD_LL_DataInStage
- >> USBD_CtlError
- >> USBD_StdEPReq

USBD_LL_Start (Thumb, 18 bytes, Stack size 8 bytes, usbd_conf.o(i.USBD_LL_Start))

[Stack]

- Max Depth = 40
- Call Chain = USBD_LL_Start ⇒ HAL_PCD_Start ⇒ USB_DevConnect ⇒ HAL_Delay

[Calls]

- >> HAL_PCD_Start
- >> USBD_Get_USB_Status

[Called By]

- >> USBD_Start

USBD_LL_Suspend (Thumb, 18 bytes, Stack size 0 bytes, usbd_core.o(i.USBD_LL_Suspend))

[Called By]

- >> HAL_PCD_SuspendCallback
- >> HAL_PCDEx_LPM_Callback

USBD_LL_Transmit (Thumb, 18 bytes, Stack size 8 bytes, usbd_conf.o(i.USBD_LL_Transmit))

[Stack]

- Max Depth = 64
- Call Chain = USBD_LL_Transmit ⇒ HAL_PCD_EP_Transmit ⇒ USB_EPStartXfer ⇒ USB_WritePacket

[Calls]

- >> HAL_PCD_EP_Transmit
- >> USBD_Get_USB_Status

[Called By]

- >> USBD_CDC_DataIn
- >> USBD_CtlSendData
- >> USBD_CtlSendStatus
- >> USBD_CtlContinueSendData

USBD_ParseSetupRequest (Thumb, 42 bytes, Stack size 16 bytes, usbd_ctlreq.o(i.USBD_ParseSetupRequest))

[Stack]

- Max Depth = 16
- Call Chain = USBD_ParseSetupRequest

[Calls]

- >> SWAPBYTE

[Called By]

- >> USBD_LL_SetupStage

USBD_RegisterClass (Thumb, 34 bytes, Stack size 16 bytes, usbd_core.o(i.USBD_RegisterClass))

[Stack]

- Max Depth = 16
- Call Chain = USBD_RegisterClass

[Called By]

- >> MX_USB_DEVICE_Init

USBD_SetClassConfig (Thumb, 20 bytes, Stack size 0 bytes, usbd_core.o(i.USBD_SetClassConfig))

[Called By]

- >> USBD_SetConfig

USBD_Start (Thumb, 4 bytes, Stack size 0 bytes, usbd_core.o(i.USBD_Start))

[Stack]

- Max Depth = 40
- Call Chain = USBD_Start ⇒ USBD_LL_Start ⇒ HAL_PCD_Start ⇒ USB_DevConnect ⇒ HAL_Delay

[Calls]

- >> USBD_LL_Start

[Called By]

- >> MX_USB_DEVICE_Init

USBD_StdDevReq (Thumb, 278 bytes, Stack size 24 bytes, usbd_ctlreq.o(i.USBD_StdDevReq))

[Stack]

- Max Depth = 120
- Call Chain = USBD_StdDevReq ⇒ USBD_SetConfig ⇒ USBD_CtlSendStatus ⇒ USBD_LL_Transmit ⇒ HAL_PCD_EP_Transmit ⇒ USB_EPStartXfer ⇒ USB_WritePacket

[Calls]

- >> USBD_LL_SetUSBAddress
- >> USBD_CtlSendData
- >> USBD_CtlError
- >> USBD_SetConfig
- >> USBD_GetDescriptor
- >> USBD_CtlSendStatus

[Called By]

- >> USBD_LL_SetupStage

USBD_StdEPReq (Thumb, 332 bytes, Stack size 24 bytes, usbd_ctlreq.o(i.USBD_StdEPReq))

[Stack]

- Max Depth = 96
- Call Chain = USBD_StdEPReq ⇒ USBD_CtlSendData ⇒ USBD_LL_Transmit ⇒ HAL_PCD_EP_Transmit ⇒ USB_EPStartXfer ⇒ USB_WritePacket

[Calls]

- >> USBD_LL_StallEP
- >> USBD_LL_IsStallEP
- >> USBD_LL_ClearStallEP
- >> USBD_CtlSendData
- >> USBD_CtlError
- >> USBD_CtlSendStatus

[Called By]

- >> USBD_LL_SetupStage

USBD_StdItfReq (Thumb, 84 bytes, Stack size 16 bytes, usbd_ctlreq.o(i.USBD_StdItfReq))

[Stack]

- Max Depth = 88
- Call Chain = USBD_StdItfReq ⇒ USBD_CtlSendStatus ⇒ USBD_LL_Transmit ⇒ HAL_PCD_EP_Transmit ⇒ USB_EPStartXfer ⇒ USB_WritePacket

[Calls]

- >> USBD_CtlError
- >> USBD_CtlSendStatus

[Called By]

- >> USBD_LL_SetupStage

USB_ActivateEndpoint (Thumb, 124 bytes, Stack size 16 bytes, stm32f7xx_ll_usb.o(i.USB_ActivateEndpoint))

[Stack]

- Max Depth = 16
- Call Chain = USB_ActivateEndpoint

[Called By]

- >> HAL_PCD_EP_Open

USB_ActivateSetup (Thumb, 28 bytes, Stack size 0 bytes, stm32f7xx_ll_usb.o(i.USB_ActivateSetup))

[Called By]

- >> HAL_PCD_IRQHandler

USB_CoreInit (Thumb, 104 bytes, Stack size 16 bytes, stm32f7xx_ll_usb.o(i.USB_CoreInit))

[Stack]

- Max Depth = 16
- Call Chain = USB_CoreInit

[Calls]

- >> USB_CoreReset

[Called By]

- >> HAL_PCD_Init

USB_DeactivateEndpoint (Thumb, 194 bytes, Stack size 16 bytes, stm32f7xx_ll_usb.o(i.USB_DeactivateEndpoint))

[Stack]

- Max Depth = 16
- Call Chain = USB_DeactivateEndpoint

[Called By]

- >> HAL_PCD_EP_Close

USB_DevConnect (Thumb, 24 bytes, Stack size 8 bytes, stm32f7xx_ll_usb.o(i.USB_DevConnect))

[Stack]

- Max Depth = 24
- Call Chain = USB_DevConnect ⇒ HAL_Delay

[Calls]

- >> HAL_Delay

[Called By]

- >> HAL_PCD_Start

USB_DevDisconnect (Thumb, 24 bytes, Stack size 8 bytes, stm32f7xx_ll_usb.o(i.USB_DevDisconnect))

[Stack]

- Max Depth = 24
- Call Chain = USB_DevDisconnect ⇒ HAL_Delay

[Calls]

- >> HAL_Delay

[Called By]

- >> HAL_PCD_Init

USB_DevInit (Thumb, 372 bytes, Stack size 36 bytes, stm32f7xx_ll_usb.o(i.USB_DevInit))

[Stack]

- Max Depth = 36
- Call Chain = USB_DevInit

[Calls]

- >> USB_FlushTxFifo
- >> USB_FlushRxFifo

[Called By]

- >> HAL_PCD_Init

USB_DisableGlobalInt (Thumb, 12 bytes, Stack size 0 bytes, stm32f7xx_ll_usb.o(i.USB_DisableGlobalInt))

[Called By]

- >> HAL_PCD_Init

USB_EP0StartXfer (Thumb, 280 bytes, Stack size 16 bytes, stm32f7xx_ll_usb.o(i.USB_EP0StartXfer))

[Stack]

- Max Depth = 16
- Call Chain = USB_EP0StartXfer

[Called By]

- >> HAL_PCD_EP_Transmit
- >> HAL_PCD_EP_Receive

USB_EP0_OutStart (Thumb, 84 bytes, Stack size 8 bytes, stm32f7xx_ll_usb.o(i.USB_EP0_OutStart))

[Stack]

- Max Depth = 8
- Call Chain = USB_EP0_OutStart

[Called By]

- >> HAL_PCD_EP_SetStall
- >> PCD_EP_OutXfrComplete_int
- >> HAL_PCD_IRQHandler

USB_EPClearStall (Thumb, 88 bytes, Stack size 0 bytes, stm32f7xx_ll_usb.o(i.USB_EPClearStall))

[Called By]

- >> HAL_PCD_EP_ClrStall

USB_EPSetStall (Thumb, 88 bytes, Stack size 0 bytes, stm32f7xx_ll_usb.o(i.USB_EPSetStall))

[Called By]

- >> HAL_PCD_EP_SetStall

USB_EPStartXfer (Thumb, 482 bytes, Stack size 24 bytes, stm32f7xx_ll_usb.o(i.USB_EPStartXfer))

[Stack]

- Max Depth = 32
- Call Chain = USB_EPStartXfer ⇒ USB_WritePacket

[Calls]

- >> USB_WritePacket

[Called By]

- >> HAL_PCD_EP_Transmit
- >> HAL_PCD_EP_Receive

USB_EnableGlobalInt (Thumb, 12 bytes, Stack size 0 bytes, stm32f7xx_ll_usb.o(i.USB_EnableGlobalInt))

[Called By]

- >> HAL_PCD_Start

USB_FlushRxFifo (Thumb, 28 bytes, Stack size 0 bytes, stm32f7xx_ll_usb.o(i.USB_FlushRxFifo))

[Called By]

- >> USB_DevInit

USB_FlushTxFifo (Thumb, 32 bytes, Stack size 0 bytes, stm32f7xx_ll_usb.o(i.USB_FlushTxFifo))

[Called By]

- >> USB_DevInit
- >> HAL_PCD_IRQHandler

USB_GetDevSpeed (Thumb, 26 bytes, Stack size 0 bytes, stm32f7xx_ll_usb.o(i.USB_GetDevSpeed))

[Called By]

- >> HAL_PCD_IRQHandler

USB_GetMode (Thumb, 8 bytes, Stack size 0 bytes, stm32f7xx_ll_usb.o(i.USB_GetMode))

[Called By]

- >> HAL_PCD_IRQHandler

USB_ReadDevAllInEpInterrupt (Thumb, 14 bytes, Stack size 0 bytes, stm32f7xx_ll_usb.o(i.USB_ReadDevAllInEpInterrupt))

[Called By]

- >> HAL_PCD_IRQHandler

USB_ReadDevAllOutEpInterrupt (Thumb, 14 bytes, Stack size 0 bytes, stm32f7xx_ll_usb.o(i.USB_ReadDevAllOutEpInterrupt))

[Called By]

- >> HAL_PCD_IRQHandler

USB_ReadDevInEPInterrupt (Thumb, 36 bytes, Stack size 8 bytes, stm32f7xx_ll_usb.o(i.USB_ReadDevInEPInterrupt))

[Stack]

- Max Depth = 8
- Call Chain = USB_ReadDevInEPInterrupt

[Called By]

- >> HAL_PCD_IRQHandler

USB_ReadDevOutEPInterrupt (Thumb, 16 bytes, Stack size 0 bytes, stm32f7xx_ll_usb.o(i.USB_ReadDevOutEPInterrupt))

[Called By]

- >> HAL_PCD_IRQHandler

USB_ReadInterrupts (Thumb, 8 bytes, Stack size 0 bytes, stm32f7xx_ll_usb.o(i.USB_ReadInterrupts))

[Called By]

- >> HAL_PCD_IRQHandler

USB_ReadPacket (Thumb, 28 bytes, Stack size 8 bytes, stm32f7xx_ll_usb.o(i.USB_ReadPacket))

[Stack]

- Max Depth = 8
- Call Chain = USB_ReadPacket

[Called By]

- >> HAL_PCD_IRQHandler

USB_SetCurrentMode (Thumb, 46 bytes, Stack size 8 bytes, stm32f7xx_ll_usb.o(i.USB_SetCurrentMode))

[Stack]

- Max Depth = 24
- Call Chain = USB_SetCurrentMode ⇒ HAL_Delay

[Calls]

- >> HAL_Delay

[Called By]

- >> HAL_PCD_Init

USB_SetDevAddress (Thumb, 34 bytes, Stack size 0 bytes, stm32f7xx_ll_usb.o(i.USB_SetDevAddress))

[Called By]

- >> HAL_PCD_SetAddress

USB_SetTurnaroundTime (Thumb, 158 bytes, Stack size 0 bytes, stm32f7xx_ll_usb.o(i.USB_SetTurnaroundTime))

[Called By]

- >> HAL_PCD_IRQHandler

USB_WritePacket (Thumb, 36 bytes, Stack size 8 bytes, stm32f7xx_ll_usb.o(i.USB_WritePacket))

[Stack]

- Max Depth = 8
- Call Chain = USB_WritePacket

[Called By]

- >> USB_EPStartXfer
- >> PCD_WriteEmptyTxFifo

UsageFault_Handler (Thumb, 2 bytes, Stack size 0 bytes, stm32f7xx_it.o(i.UsageFault_Handler))

[Calls]

- >> UsageFault_Handler

[Called By]

- >> UsageFault_Handler

[Address Reference Count : 1]

- startup_stm32f765xx.o(RESET)

__scatterload_copy (Thumb, 14 bytes, Stack size unknown bytes, handlers.o(i.__scatterload_copy), UNUSED)

__scatterload_null (Thumb, 2 bytes, Stack size unknown bytes, handlers.o(i.__scatterload_null), UNUSED)

__scatterload_zeroinit (Thumb, 14 bytes, Stack size unknown bytes, handlers.o(i.__scatterload_zeroinit), UNUSED)

free (Thumb, 76 bytes, Stack size 8 bytes, malloc.o(i.free))

[Stack]

- Max Depth = 8
- Call Chain = free

[Called By]

- >> USBD_CDC_DeInit

main (Thumb, 18 bytes, Stack size 0 bytes, main.o(i.main))

[Stack]

- Max Depth = 184
- Call Chain = main ⇒ MX_USB_DEVICE_Init ⇒ USBD_Init ⇒ USBD_LL_Init ⇒ HAL_PCD_Init ⇒ HAL_PCD_MspInit ⇒ HAL_GPIO_Init

[Calls]

- >> MX_USB_DEVICE_Init
- >> MX_GPIO_Init
- >> HAL_Init
- >> SystemClock_Config

[Address Reference Count : 1]

- entry9a.o(.ARM.Collect$$$$0000000B)

malloc (Thumb, 92 bytes, Stack size 20 bytes, malloc.o(i.malloc))

[Stack]

- Max Depth = 20
- Call Chain = malloc

[Called By]

- >> USBD_CDC_Init

### Local Symbols

IntToUnicode (Thumb, 56 bytes, Stack size 20 bytes, usbd_desc.o(i.IntToUnicode))

[Stack]

- Max Depth = 20
- Call Chain = IntToUnicode

[Called By]

- >> USBD_HS_SerialStrDescriptor

CDC_Control_HS (Thumb, 4 bytes, Stack size 0 bytes, usbd_cdc_if.o(i.CDC_Control_HS))
[Address Reference Count : 1]

- usbd_cdc_if.o(.data)

CDC_DeInit_HS (Thumb, 4 bytes, Stack size 0 bytes, usbd_cdc_if.o(i.CDC_DeInit_HS))
[Address Reference Count : 1]

- usbd_cdc_if.o(.data)

CDC_Init_HS (Thumb, 24 bytes, Stack size 8 bytes, usbd_cdc_if.o(i.CDC_Init_HS))

[Stack]

- Max Depth = 8
- Call Chain = CDC_Init_HS

[Calls]

- >> USBD_CDC_SetTxBuffer
- >> USBD_CDC_SetRxBuffer

[Address Reference Count : 1]

- usbd_cdc_if.o(.data)

CDC_Receive_HS (Thumb, 20 bytes, Stack size 8 bytes, usbd_cdc_if.o(i.CDC_Receive_HS))

[Stack]

- Max Depth = 72
- Call Chain = CDC_Receive_HS ⇒ USBD_CDC_ReceivePacket ⇒ USBD_LL_PrepareReceive ⇒ HAL_PCD_EP_Receive ⇒ USB_EPStartXfer ⇒ USB_WritePacket

[Calls]

- >> USBD_CDC_SetRxBuffer
- >> USBD_CDC_ReceivePacket

[Address Reference Count : 1]

- usbd_cdc_if.o(.data)

CDC_TransmitCplt_HS (Thumb, 4 bytes, Stack size 0 bytes, usbd_cdc_if.o(i.CDC_TransmitCplt_HS))
[Address Reference Count : 1]

- usbd_cdc_if.o(.data)

PCD_EP_OutXfrComplete_int (Thumb, 194 bytes, Stack size 24 bytes, stm32f7xx_hal_pcd.o(i.PCD_EP_OutXfrComplete_int))

[Stack]

- Max Depth = 104
- Call Chain = PCD_EP_OutXfrComplete_int ⇒ HAL_PCD_DataOutStageCallback ⇒ USBD_LL_DataOutStage ⇒ USBD_CtlSendStatus ⇒ USBD_LL_Transmit ⇒ HAL_PCD_EP_Transmit ⇒ USB_EPStartXfer ⇒ USB_WritePacket

[Calls]

- >> HAL_PCD_DataOutStageCallback
- >> USB_EP0_OutStart

[Called By]

- >> HAL_PCD_IRQHandler

PCD_WriteEmptyTxFifo (Thumb, 162 bytes, Stack size 40 bytes, stm32f7xx_hal_pcd.o(i.PCD_WriteEmptyTxFifo))

[Stack]

- Max Depth = 48
- Call Chain = PCD_WriteEmptyTxFifo ⇒ USB_WritePacket

[Calls]

- >> USB_WritePacket

[Called By]

- >> HAL_PCD_IRQHandler

USB_CoreReset (Thumb, 50 bytes, Stack size 0 bytes, stm32f7xx_ll_usb.o(i.USB_CoreReset))

[Called By]

- >> USB_CoreInit

__NVIC_SetPriority (Thumb, 34 bytes, Stack size 0 bytes, stm32f7xx_hal_cortex.o(i.__NVIC_SetPriority))

[Called By]

- >> HAL_NVIC_SetPriority
- >> HAL_SYSTICK_Config

SWAPBYTE (Thumb, 10 bytes, Stack size 0 bytes, usbd_ctlreq.o(i.SWAPBYTE))

[Called By]

- >> USBD_ParseSetupRequest

USBD_GetDescriptor (Thumb, 250 bytes, Stack size 24 bytes, usbd_ctlreq.o(i.USBD_GetDescriptor))

[Stack]

- Max Depth = 96
- Call Chain = USBD_GetDescriptor ⇒ USBD_CtlSendData ⇒ USBD_LL_Transmit ⇒ HAL_PCD_EP_Transmit ⇒ USB_EPStartXfer ⇒ USB_WritePacket

[Calls]

- >> USBD_CtlSendData
- >> USBD_CtlError
- >> USBD_CtlSendStatus

[Called By]

- >> USBD_StdDevReq

USBD_SetConfig (Thumb, 184 bytes, Stack size 24 bytes, usbd_ctlreq.o(i.USBD_SetConfig))

[Stack]

- Max Depth = 96
- Call Chain = USBD_SetConfig ⇒ USBD_CtlSendStatus ⇒ USBD_LL_Transmit ⇒ HAL_PCD_EP_Transmit ⇒ USB_EPStartXfer ⇒ USB_WritePacket

[Calls]

- >> USBD_CtlError
- >> USBD_CtlSendStatus
- >> USBD_SetClassConfig
- >> USBD_ClrClassConfig

[Called By]

- >> USBD_StdDevReq

USBD_CDC_DataIn (Thumb, 96 bytes, Stack size 24 bytes, usbd_cdc.o(i.USBD_CDC_DataIn))

[Stack]

- Max Depth = 88
- Call Chain = USBD_CDC_DataIn ⇒ USBD_LL_Transmit ⇒ HAL_PCD_EP_Transmit ⇒ USB_EPStartXfer ⇒ USB_WritePacket

[Calls]

- >> USBD_LL_Transmit

[Address Reference Count : 1]

- usbd_cdc.o(.data)

USBD_CDC_DataOut (Thumb, 42 bytes, Stack size 16 bytes, usbd_cdc.o(i.USBD_CDC_DataOut))

[Stack]

- Max Depth = 16
- Call Chain = USBD_CDC_DataOut

[Calls]

- >> USBD_LL_GetRxDataSize

[Address Reference Count : 1]

- usbd_cdc.o(.data)

USBD_CDC_DeInit (Thumb, 74 bytes, Stack size 16 bytes, usbd_cdc.o(i.USBD_CDC_DeInit))

[Stack]

- Max Depth = 56
- Call Chain = USBD_CDC_DeInit ⇒ USBD_LL_CloseEP ⇒ HAL_PCD_EP_Close ⇒ USB_DeactivateEndpoint

[Calls]

- >> USBD_LL_CloseEP
- >> free

[Address Reference Count : 1]

- usbd_cdc.o(.data)

USBD_CDC_EP0_RxReady (Thumb, 36 bytes, Stack size 8 bytes, usbd_cdc.o(i.USBD_CDC_EP0_RxReady))

[Stack]

- Max Depth = 8
- Call Chain = USBD_CDC_EP0_RxReady

[Address Reference Count : 1]

- usbd_cdc.o(.data)

USBD_CDC_GetFSCfgDesc (Thumb, 8 bytes, Stack size 0 bytes, usbd_cdc.o(i.USBD_CDC_GetFSCfgDesc))
[Address Reference Count : 1]

- usbd_cdc.o(.data)

USBD_CDC_GetHSCfgDesc (Thumb, 8 bytes, Stack size 0 bytes, usbd_cdc.o(i.USBD_CDC_GetHSCfgDesc))
[Address Reference Count : 1]

- usbd_cdc.o(.data)

USBD_CDC_GetOtherSpeedCfgDesc (Thumb, 8 bytes, Stack size 0 bytes, usbd_cdc.o(i.USBD_CDC_GetOtherSpeedCfgDesc))
[Address Reference Count : 1]

- usbd_cdc.o(.data)

USBD_CDC_Init (Thumb, 162 bytes, Stack size 32 bytes, usbd_cdc.o(i.USBD_CDC_Init))

[Stack]

- Max Depth = 88
- Call Chain = USBD_CDC_Init ⇒ USBD_LL_PrepareReceive ⇒ HAL_PCD_EP_Receive ⇒ USB_EPStartXfer ⇒ USB_WritePacket

[Calls]

- >> USBD_LL_PrepareReceive
- >> USBD_LL_OpenEP
- >> malloc

[Address Reference Count : 1]

- usbd_cdc.o(.data)

USBD_CDC_Setup (Thumb, 178 bytes, Stack size 32 bytes, usbd_cdc.o(i.USBD_CDC_Setup))

[Stack]

- Max Depth = 104
- Call Chain = USBD_CDC_Setup ⇒ USBD_CtlSendData ⇒ USBD_LL_Transmit ⇒ HAL_PCD_EP_Transmit ⇒ USB_EPStartXfer ⇒ USB_WritePacket

[Calls]

- >> USBD_CtlPrepareRx
- >> USBD_CtlSendData
- >> USBD_CtlError

[Address Reference Count : 1]

- usbd_cdc.o(.data)

### Undefined Global Symbols
