OuyangJunyuan/Bus_Adaptor-PCB/BusAdaptor_v2.0/Bus_Adaptor_Hw/Project Outputs for Bus_Adaptor_Hw-v2/Bus_Adaptor_Hw-v2.xls

Comment | Description | Designator | Footprint | LibRef | Quantity
10uF |  | C1, C5, C33, C36 | 0402_C | C | 4
12pF |  | C2, C3 | 0402_C | C | 2
100nF |  | C4, C7, C12, C13, C14, C15, C18, C21, C24, C25, C26, C27, C30, C34, C35, C39, C41 | 0402_C | C | 17 | x
1uF |  | C6, C22 | 0402_C | C | 2
2.2uF |  | C9, C10, C29 | 0402_C | C | 3 | x
1000pF/2KV |  | C11 | 1206_C | C | 1 | x
15pF |  | C16, C17, C49, C50 | 0402_C | C | 4 | x
4.7uF |  | C19, C20, C23 | 0402_C | C | 3 | x
33nF |  | C28 | 0402_C | C | 1 | x
10nF |  | C31, C37, C40 | 0402_C | C | 3 | x
220pF |  | C32 | 0402_C | C | 1 | x
1nF |  | C38 | 0402_C | C | 1 | x
1.5pF |  | C42 | 0402_C | C | 1 | x
47uF |  | C43 | 0805_C | C | 1 | x
1.0pF |  | C44, C45 | 0402_C | C | 2
1pF |  | C46 | 0402_C | C | 1
2.2nF |  | C47 | 0402_C | C | 1 | x
4.7pF |  | C48 | 0402_C | C | 1 | x
SMBJ3.3/MSP3V3HM3/89A-C241899 | BV03CW | D1, D3 | SMA | TVS | 2 | x
GREEN 0603 |  | D2, D5 | 0603_LED_S1 | LED | 2 | x
PUSB3FR4Z | C503418 | D6, D7, D8, D9, D10, D11, D12, D13 | DFN2510A-10_L2.5-W1.0-P0.50-BL | TVS10P-4PAIR | 8
TVS10P-4PAIR | C503418 | D14 | DFN2510A-10_L2.5-W1.0-P0.50-BL | TVS10P-4PAIR | 1
Antenna | Generic Antenna | E1 | IPEX | Antenna | 1
500mA | FUSE | F1 | 0805_R | FUSE | 1
8P-2EP | FPC-8P | H1 | FPC-SMD_8P-P0.50_F0500WR-S-08PNLNG1GT0R | 8P-2EP | 1
HEADER-4 |  | J1 | HDR-1X4 | HEADER-4 | 1
C495892 |  | Key1 | SW-SMD_侧开/5脚 | KEY | 1
120R@100M/C365235 |  | L1 | 0805_L | L | 1
1K@100MHz |  | L2 | 0603_L | L | 1 | x
10uH |  | L3 | 0603_L | L | 1
3.9nH |  | L4, L5 | 0402_L | L | 2 | x
8.2nH |  | L6 | 0402_L | L | 1 | x
2.7nH |  | L7 | 0402_L | L | 1
RGB-1.6x1.6 | 3528三基色LED | LED1 | RGB-1.6X1.6 | LED-RGB 3528 | 1
NRF24L01 |  | NRF1 | QFN-20_4X4X05P | NRF24L01 | 1
TYPE_C | TYPE_C | P1 | TYPE-C-TOP | USB_C | 1
MINI_PCIE |  | P2 | MINIPCIE | MINI_PCIE | 1
10K | resistor | R1, R2, R5, R7 | 0402_R | R | 4 | x
100R | resistor | R3 | 0402_R | R | 1
R_array4 |  | R4 | RES-ARRAY-SMD_0201-8P-L1.4-W0.6-BL | R_array4 | 1
1M | resistor | R6, R8 | 0402_R | R | 2
12K 1% | resistor | R9 | 0402_R | R | 1 | x
0R | resistor | R10, R13 | 0201 | R | 2
22K 1% | resistor | R11 | 0402_R | R | 1 | x
120R | resistor | R12, R14 | 0402_R | R | 2
2K | resistor | R15 | 0402_R | R | 1
0R/10uH | resistor | R16 | 0805_L | R | 1
1K | resistor | R17, R18, R23 | 0402_R | R | 3
STM32F765VGH6 |  | U1 | TFBGA100, 8*8*0.8 MM | STM32F765VGH6 | 1
HS USB PHY | 高速USB外置PHY | U2 | QFN50P500X500X100-32N | USB3300 | 1
TJA1059 | double can | U3 | HVSON-14_L4.5-W3.0-P0.65-BL-EP | TJA1059 | 1
SPX3819M5-L-3-3 |  | U4 | SOT-23-5 | ME6211 | 1
RFX2401C |  | U5 | RFX2401C | RFX2401C | 1
LP5907 |  | U6 | SOT-23-5 | LP5907 | 1
25M-8pF/C193187 | 4脚无源晶振 | XT1 | OSC-SMD_4P-L2.0-W1.6-BL | XTAL-4P | 1
24M-10pF/C108160 | 4脚无源晶振 | XT2 | OSC-SMD_4P-L2.0-W1.6-BL | XTAL-4P | 1
16M-12pF/C108155 | 4脚无源晶振 | XT3 | OSC-SMD_4P-L2.0-W1.6-BL | XTAL-4P | 1
