OuyangJunyuan/Bus_Adaptor-PCB/BusAdaptor_v2.0/3dmodel/User Library-SOT1176-1-1.STEP

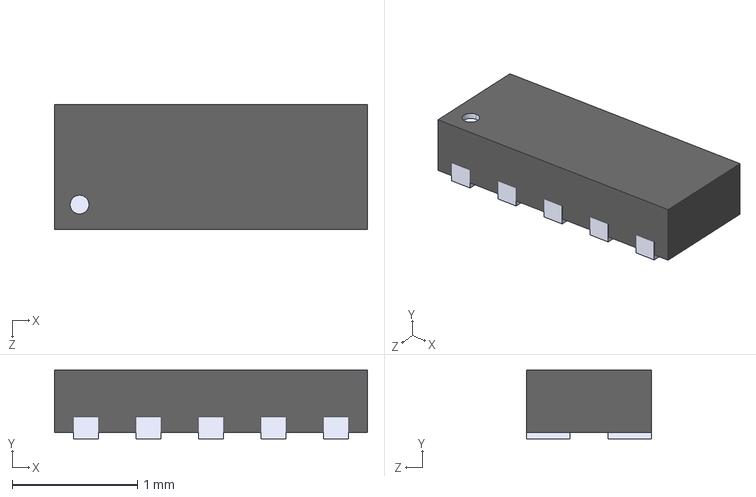
[picture p13: CAD file, 2020-09-12]
BusAdaptor_v2.0/3dmodel/User Library-SOT1176-1-1.STEP
2.50 x 0.55 x 1.00 mm
