OuyangJunyuan/Bus_Adaptor-PCB/BusAdaptor_v2.0/3dmodel/User Library-TFBGA100.STEP

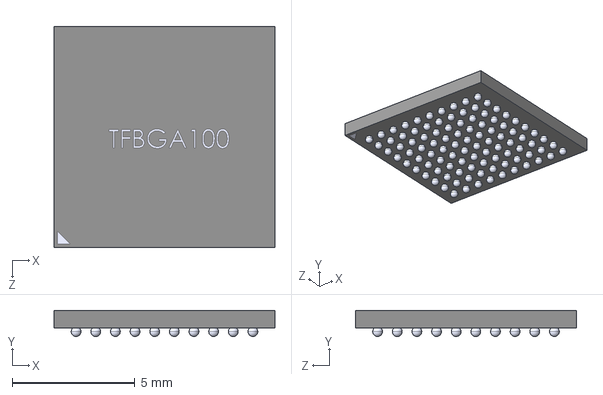
[picture p14: CAD file, 2020-09-12]
BusAdaptor_v2.0/3dmodel/User Library-TFBGA100.STEP
9.00 x 1.06 x 9.00 mm
