OuyangJunyuan/Bus_Adaptor-PCB/BusAdaptor_v2.0/3dmodel/User Library-TJA1043TK.STEP

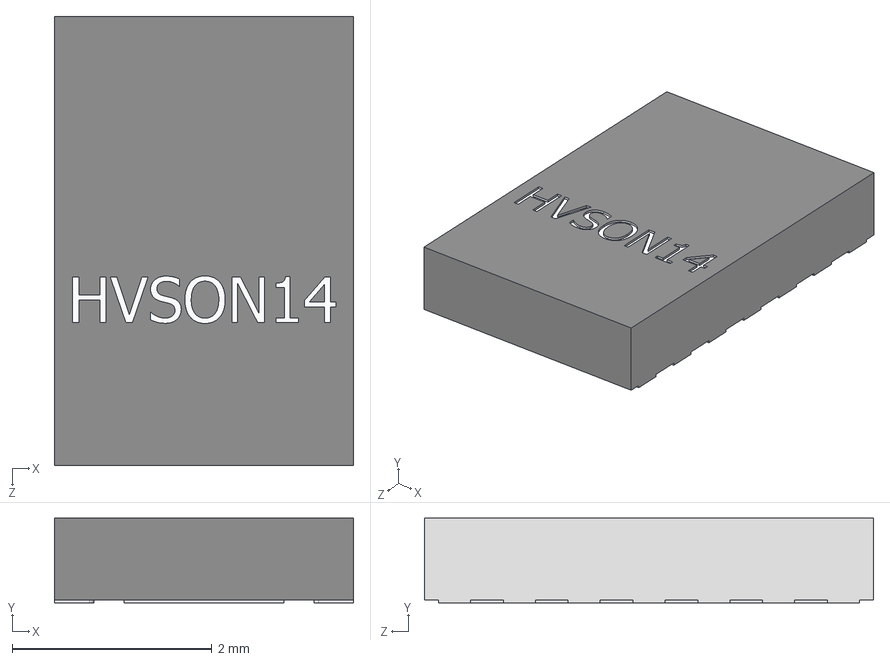
[picture p15: CAD file, 2020-09-12]
BusAdaptor_v2.0/3dmodel/User Library-TJA1043TK.STEP
3.00 x 0.85 x 4.50 mm
