OuyangJunyuan/Bus_Adaptor-PCB/BusAdaptor_v1.0/3D模型/AD模型/IPEX/User Library-IPEX.STEP

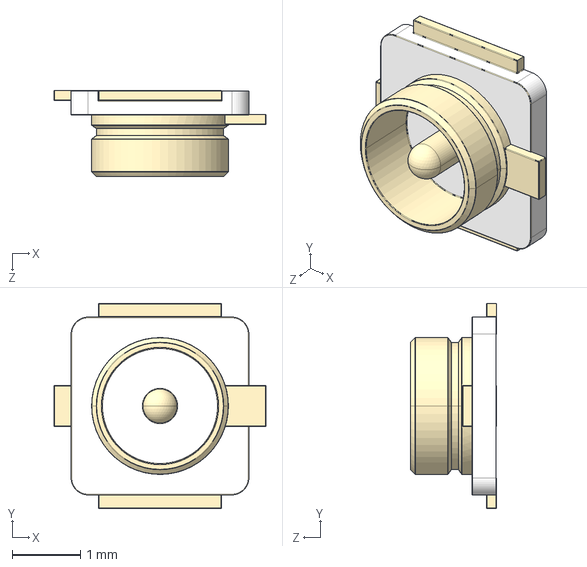
[picture p16: CAD file, 2020-09-12, an earlier design]
BusAdaptor_v1.0/3D模型/AD模型/IPEX/User Library-IPEX.STEP
3.10 x 3.00 x 1.26 mm
