OuyangJunyuan/Bus_Adaptor-PCB/BusAdaptor_v1.0/3D模型/AD模型/KLJ-8530/3D (1)/CMT-8503-85B-SMT-TR.stp

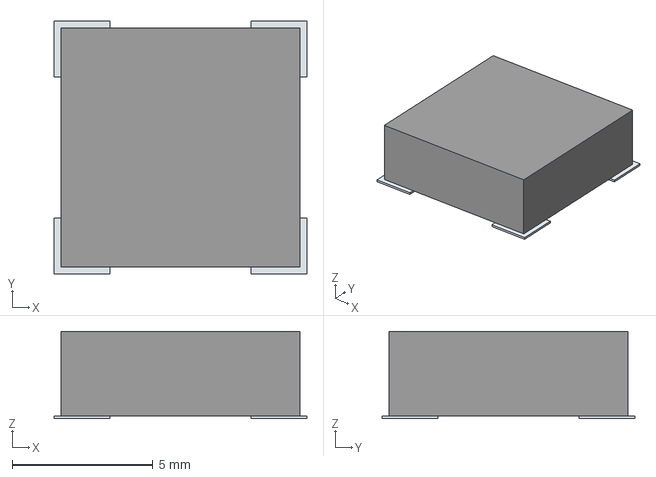
[picture p17: CAD file, 2020-06-10, an earlier design]
BusAdaptor_v1.0/3D模型/AD模型/KLJ-8530/3D (1)/CMT-8503-85B-SMT-TR.stp
9.00 x 9.00 x 3.10 mm
Pins
