OuyangJunyuan/Bus_Adaptor-PCB/BusAdaptor_v1.0/3D模型/AD模型/QFN-20/User Library-QFN20_4x4x0_8.STEP

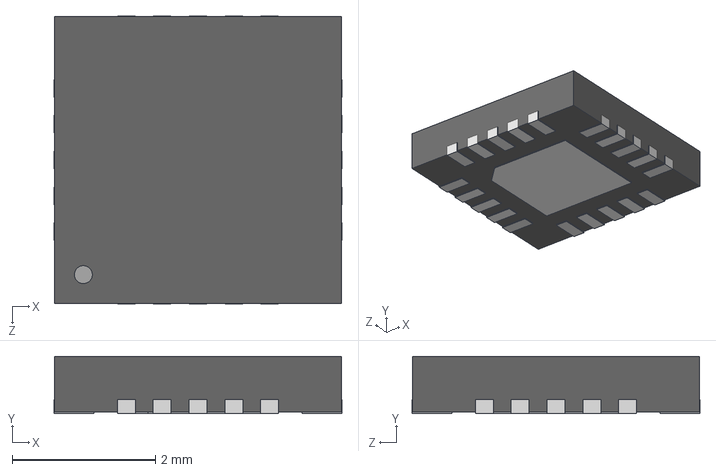
[picture p19: CAD file, 2020-09-12, an earlier design]
BusAdaptor_v1.0/3D模型/AD模型/QFN-20/User Library-QFN20_4x4x0_8.STEP
4.02 x 0.8 x 4.02 mm
