OuyangJunyuan/Bus_Adaptor-PCB/BusAdaptor_v1.0/3D模型/AD模型/SMB/SMBJ30A.stp

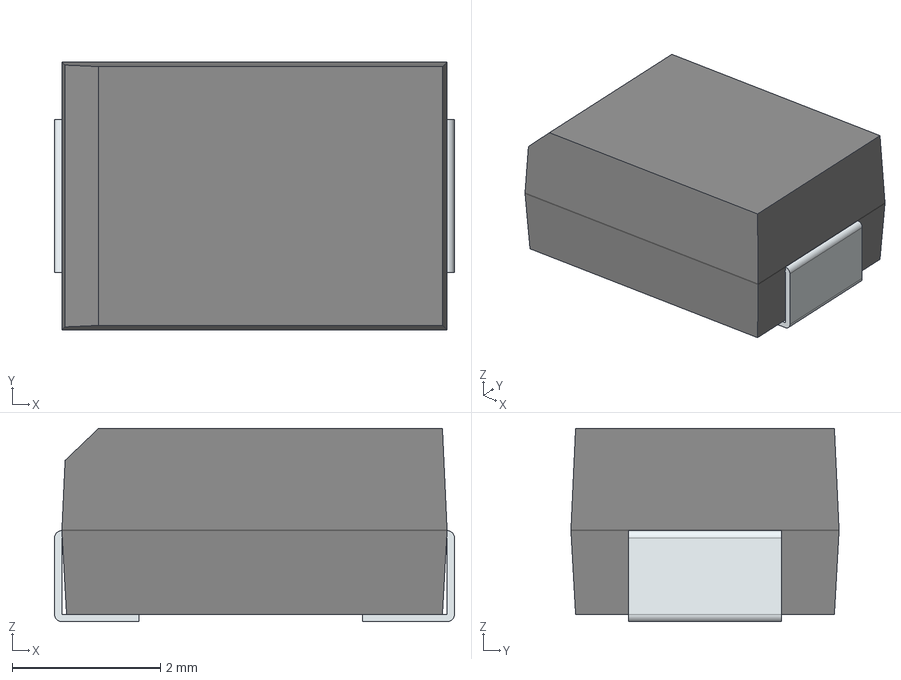
[picture p20: CAD file, 2020-06-10, an earlier design]
BusAdaptor_v1.0/3D模型/AD模型/SMB/SMBJ30A.stp
5.40 x 3.62 x 2.61 mm
FilletPin1
FilletPin2
