OuyangJunyuan/Bus_Adaptor-PCB/BusAdaptor_v1.0/3D模型/AD模型/SOIC-16/User Library-SOIC16-150.STEP

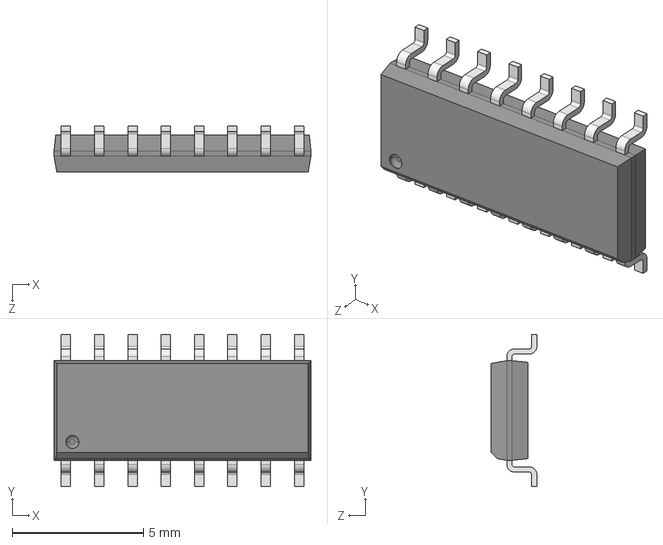
[picture p21: CAD file, 2020-09-12, an earlier design]
BusAdaptor_v1.0/3D模型/AD模型/SOIC-16/User Library-SOIC16-150.STEP
9.80 x 5.80 x 1.75 mm
