OuyangJunyuan/Bus_Adaptor-PCB/BusAdaptor_v1.0/3D模型/AD模型/SOIC-8_150mil/User Library-so8-3.STEP

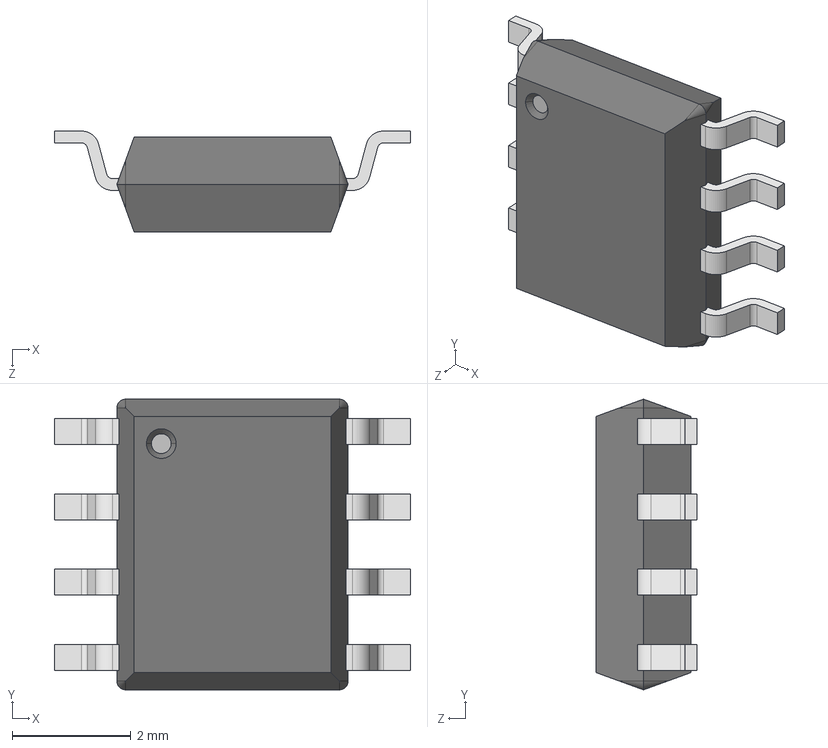
[picture p22: CAD file, 2020-09-12, an earlier design]
BusAdaptor_v1.0/3D模型/AD模型/SOIC-8_150mil/User Library-so8-3.STEP
6.00 x 4.90 x 1.70 mm
