OuyangJunyuan/Bus_Adaptor-PCB/BusAdaptor_v1.0/3D模型/AD模型/SOT-23-5/CircuitWorks-SOT-23-5.STEP

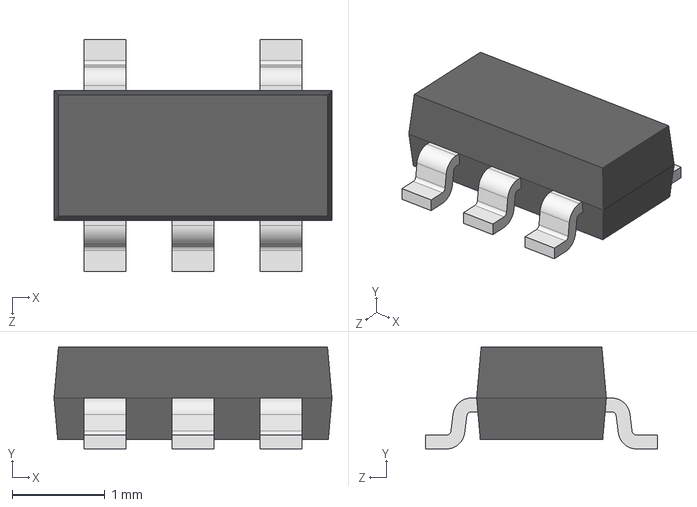
[picture p23: CAD file, 2020-09-12, an earlier design]
BusAdaptor_v1.0/3D模型/AD模型/SOT-23-5/CircuitWorks-SOT-23-5.STEP
3.00 x 1.10 x 2.50 mm
