OuyangJunyuan/Bus_Adaptor-PCB/BusAdaptor_v1.0/3D模型/AD模型/QFN-20/User Library-QFN4x4_20pins.STEP

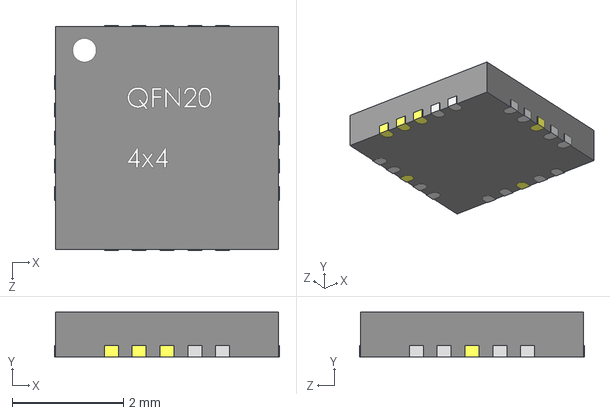
[picture p24: CAD file, 2020-09-12, an earlier design]
BusAdaptor_v1.0/3D模型/AD模型/QFN-20/User Library-QFN4x4_20pins.STEP
4.04 x 0.802 x 4.04 mm
