OuyangJunyuan/Bus_Adaptor-PCB/BusAdaptor_v1.0/3D模型/AD模型/SOIC-8_150mil/SN65HVD230DR.stp

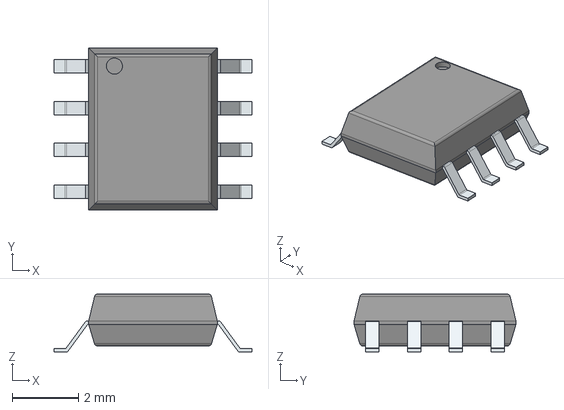
[picture p25: CAD file, 2020-06-10, an earlier design]
BusAdaptor_v1.0/3D模型/AD模型/SOIC-8_150mil/SN65HVD230DR.stp
6.00 x 4.91 x 1.75 mm
PinsArrayLR
