OuyangJunyuan/Bus_Adaptor-PCB/(list of files, cad)

Other CAD files:
BusAdaptor_v2.0/Bus_Adaptor_Sw/backup/显示代码/11-0.96寸ips-51(模拟SPI中文显示)/11-0.96寸ips-51(模拟SPI中文显示)/STC_SoftSPI_CNCode(模拟SPI中文显示)/Out Hex/282838p.obj
BusAdaptor_v2.0/Bus_Adaptor_Sw/backup/显示代码/12-0.96寸ips-51(图片显示)/12-0.96寸ips-51(图片显示)/PictureTest_SoftSPI(图片显示)/Out Hex/282838p.obj
BusAdaptor_v1.0/3D模型/AD模型/KLJ-8530/3D (1)/CMT-8503-85B-SMT-TR.stl
BusAdaptor_v1.0/3D模型/AD模型/SMB/SMBJ30A.stl
BusAdaptor_v1.0/3D模型/AD模型/SOIC-8_150mil/SN65HVD230DR.stl
