OuyangJunyuan/Bus_Adaptor-PCB/BusAdaptor_v2.0/Bus_Adaptor_Hw/Bus_Adaptor_Hw-v2.pdf

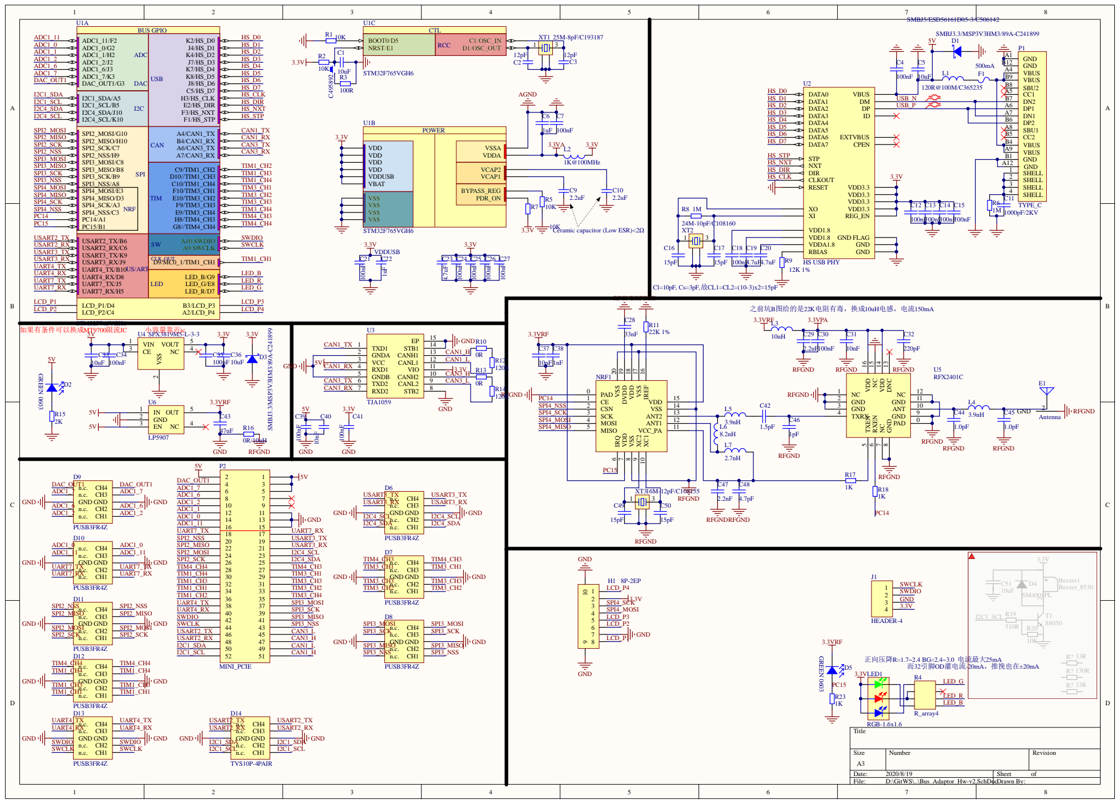
[picture p26: page 1]

Ceramic capacitor (Low ESR)<2Ω

C28 3.3VRF 3.3VPA

如果有条件可以换成MT9700限流IC 小容量靠近ic 5V U4 SPX3819M5-L-3-3 3.3V 3.3V | U3

12 NC 13 VDD 14 NC 15 VDD 16

15 REF 16 VSS 17 VDD 18 DVDD 19 VSS 20
NRF1

GND 8 GND 9 ANT 10 GND 11 NC D

ADC1_6 | ADC1_6

I2C4_SCL | I2C4_SCL

Comment | Description | Designator | Footprint | LibRef | Quantity
10uF | | C1 | 0402_C | C | 1
12pF | | C2 | 0402_C | C | 1
12pF | | C3 | 0402_C | C | 1
100nF | | C4 | 0402_C | C | 1
10uF | | C5 | 0402_C | C | 1
1uF | | C6 | 0402_C | C | 1
100nF | | C7 | 0402_C | C | 1
2.2uF | | C9 | 0402_C | C | 1
2.2uF | | C10 | 0402_C | C | 1
1000pF/2KV | | C11 | 1206_C | C | 1
100nF | | C12 | 0402_C | C | 1
100nF | | C13 | 0402_C | C | 1
100nF | | C14 | 0402_C | C | 1
100nF | | C15 | 0402_C | C | 1
15pF | | C16 | 0402_C | C | 1
15pF | | C17 | 0402_C | C | 1
100nF | | C18 | 0402_C | C | 1
4.7uF | | C19 | 0402_C | C | 1
4.7uF | | C20 | 0402_C | C | 1
100nF | | C21 | 0402_C | C | 1
1uF | | C22 | 0402_C | C | 1
4.7uF | | C23 | 0402_C | C | 1
100nF | | C24 | 0402_C | C | 1
100nF | | C25 | 0402_C | C | 1
100nF | | C26 | 0402_C | C | 1
100nF | | C27 | 0402_C | C | 1
33nF | | C28 | 0402_C | C | 1
2.2uF | | C29 | 0402_C | C | 1
100nF | | C30 | 0402_C | C | 1
10nF | | C31 | 0402_C | C | 1
220pF | | C32 | 0402_C | C | 1
10uF | | C33 | 0402_C | C | 1
100nF | | C34 | 0402_C | C | 1
100nF | | C35 | 0402_C | C | 1
10uF | | C36 | 0402_C | C | 1
10nF | | C37 | 0402_C | C | 1
1nF | | C38 | 0402_C | C | 1
100nF | | C39 | 0402_C | C | 1
10nF | | C40 | 0402_C | C | 1
100nF | | C41 | 0402_C | C | 1
1.5pF | | C42 | 0402_C | C | 1
47uF | | C43 | 0805_C | C | 1
1.0pF | | C44 | 0402_C | C | 1
1.0pF | | C45 | 0402_C | C | 1
1pF | | C46 | 0402_C | C | 1
2.2nF | | C47 | 0402_C | C | 1
4.7pF | | C48 | 0402_C | C | 1
15pF | | C49 | 0402_C | C | 1
15pF | | C50 | 0402_C | C | 1
SMBJ3.3/MSP3V3HM3/89A-C241899 BV03CW | | D1 | SMA | TVS | 1
GREEN 0603 | | D2 | 0603_LED_S1 | LED | 1
SMBJ3.3/MSP3V3HM3/89A-C241899 BV03CW | | D3 | SMA | TVS | 1
GREEN 0603 | | D5 | 0603_LED_S1 | LED | 1
PUSB3FR4Z | C503418 | D6 | DFN2510A-10_L2.5-W1.0-P0.50-BL TVS10P-4PAIR | | 1
PUSB3FR4Z | C503418 | D7 | DFN2510A-10_L2.5-W1.0-P0.50-BL TVS10P-4PAIR | | 1
PUSB3FR4Z | C503418 | D8 | DFN2510A-10_L2.5-W1.0-P0.50-BL TVS10P-4PAIR | | 1
PUSB3FR4Z | C503418 | D9 | DFN2510A-10_L2.5-W1.0-P0.50-BL TVS10P-4PAIR | | 1
PUSB3FR4Z | C503418 | D10 | DFN2510A-10_L2.5-W1.0-P0.50-BL TVS10P-4PAIR | | 1
PUSB3FR4Z | C503418 | D11 | DFN2510A-10_L2.5-W1.0-P0.50-BL TVS10P-4PAIR | | 1
PUSB3FR4Z | C503418 | D12 | DFN2510A-10_L2.5-W1.0-P0.50-BL TVS10P-4PAIR | | 1
PUSB3FR4Z | C503418 | D13 | DFN2510A-10_L2.5-W1.0-P0.50-BL TVS10P-4PAIR | | 1
TVS10P-4PAIR | C503418 | D14 | DFN2510A-10_L2.5-W1.0-P0.50-BL TVS10P-4PAIR | | 1
Antenna | Generic Antenna | E1 | IPEX | Antenna | 1
500mA | FUSE | F1 | 0805_R | FUSE | 1
8P-2EP | FPC-8P | H1 | FPC-SMD_8P-P0.50_F0500WR-S-08PNLNG1GT0R 8P-2EP | | 1
HEADER-4 | | J1 | HDR-1X4 | HEADER-4 | 1
C495892 | | Key1 | SW-SMD_侧开/5脚KEY | | 1
120R@100M/C365235 | | L1 | 0805_L | L | 1
1K@100MHz | | L2 | 0603_L | L | 1
10uH | | L3 | 0603_L | L | 1
3.9nH | | L4 | 0402_L | L | 1
3.9nH | | L5 | 0402_L | L | 1
8.2nH | | L6 | 0402_L | L | 1
2.7nH | | L7 | 0402_L | L | 1
RGB-1.6x1.6 | 3528三基色LED | LED1 | RGB-1.6x1.6 | LED-RGB 3528 | 1
NRF24L01 | | NRF1 | QFN-20_4x4x05P | NRF24L01 | 1
TYPE_C | TYPE_C | P1 | TYPE-C-TOP | USB_C | 1
MINI_PCIE | | P2 | MINIPCIE | MINI_PCIE | 1
10K | resistor | R1 | 0402_R | R | 1
10K | resistor | R2 | 0402_R | R | 1
100R | resistor | R3 | 0402_R | R | 1
R_array4 | | R4 | RES-ARRAY-SMD_0201-8P-L1.4-W0.6-BL R_array4 | | 1
10K | resistor | R5 | 0402_R | R | 1
1M | resistor | R6 | 0402_R | R | 1
10K | resistor | R7 | 0402_R | R | 1
1M | resistor | R8 | 0402_R | R | 1
12K 1% | resistor | R9 | 0402_R | R | 1
0R | resistor | R10 | 201 | R | 1
22K 1% | resistor | R11 | 0402_R | R | 1
120R | resistor | R12 | 0402_R | R | 1
0R | resistor | R13 | 201 | R | 1
120R | resistor | R14 | 0402_R | R | 1
2K | resistor | R15 | 0402_R | R | 1
0R/10uH | resistor | R16 | 0805_L | R | 1
1K | resistor | R17 | 0402_R | R | 1
1K | resistor | R18 | 0402_R | R | 1
1K | resistor | R23 | 0402_R | R | 1
STM32F765VGH6 | | U1 | TFBGA100, 8*8*0.8 mmSTM32F765VGH6 | | 1
HS USB PHY | 高速USB外置PHY | U2 | QFN50P500X500X100-32N USB3300 | | 1
TJA1059 | double can | U3 | HVSON-14_L4.5-W3.0-P0.65-BL-EP TJA1059 | | 1
SPX3819M5-L-3-3 | | U4 | SOT-23-5 | ME6211 | 1
RFX2401C | | U5 | RFX2401C | RFX2401C | 1
LP5907 | | U6 | SOT-23-5 | LP5907 | 1
25M-8pF/C193187 | 4脚无源晶振 | XT1 | OSC-SMD_4P-L2.0-W1.6-BL XTAL-4P | | 1
24M-10pF/C1081604脚无源晶振 | | XT2 | OSC-SMD_4P-L2.0-W1.6-BL XTAL-4P | | 1
16M-12pF/C1081554脚无源晶振 | | XT3 | OSC-SMD_4P-L2.0-W1.6-BL XTAL-4P | | 1
