OuyangJunyuan/Bus_Adaptor-PCB/(list of files, drawings)

Other design files:
BusAdaptor_v1.0/nrf24l01+lna+pa_PCB/可用/NRF24L01PA-MINI_2020-04-24_02-18-02.pcbdoc
BusAdaptor_v1.0/nrf24l01+lna+pa_PCB/可用/Sheet_1_2020-04-24_02-18-40.schdoc
BusAdaptor_v1.0/nrf24l01+lna+pa_PCB/稳定/NRF24L01_PA.PcbDoc
BusAdaptor_v1.0/nrf24l01+lna+pa_PCB/稳定/NRF24L01_PA.PcbLib
BusAdaptor_v1.0/nrf24l01+lna+pa_PCB/稳定/NRF24L01_PA.PrjPcb
BusAdaptor_v1.0/nrf24l01+lna+pa_PCB/稳定/NRF24L01_PA.SchDoc
BusAdaptor_v1.0/nrf24l01+lna+pa_PCB/稳定/NRF24L01_PA.SCHLIB
BusAdaptor_v1.0/NRF24L01+PA+LAN/NRF24L01+PA+LAN.PcbDoc
BusAdaptor_v1.0/NRF24L01+PA+LAN/NRF24L01+PA+LAN/History/NRF24L01+PA+LAN.~(1).PcbDoc/NRF24L01+PA+LAN.~(1).PcbDoc
BusAdaptor_v1.0/NRF24L01+PA+LAN/NRF24L01+PA+LAN/NRF24L01+PA+LAN.PcbDoc
BusAdaptor_v1.0/PCB工程/Bus_Adaptor_Hw.PrjPcb
BusAdaptor_v1.0/PCB工程/BusAdaptor.PcbLib
BusAdaptor_v1.0/PCB工程/BusAdaptor.SchDoc
BusAdaptor_v1.0/PCB工程/BusAdaptor.SchLib
BusAdaptor_v1.0/PCB工程/Docking.PcbDoc
BusAdaptor_v1.0/PCB工程/Docking.SchDoc
BusAdaptor_v1.0/商家/USB2XXX (1).SchDoc
BusAdaptor_v1.0/商家/USB2XXX.SchDoc
BusAdaptor_v2.0/Bus_Adaptor_Hw/Bus_Adaptor_Hw-v2.PrjPcb
BusAdaptor_v2.0/Bus_Adaptor_Hw/Bus_Adaptor_Hw-v2.SchDoc
BusAdaptor_v2.0/Bus_Adaptor_Hw/BusAdaptor.PcbLib
BusAdaptor_v2.0/Bus_Adaptor_Hw/BusAdaptor.SchLib
BusAdaptor_v2.0/Bus_Adaptor_Hw/WTR-SCH_LIB.SchLib
