OuyangJunyuan/Bus_Adaptor-PCB/BusAdaptor_v2.0/Bus_Adaptor_Sw/STM32/BusAdator_v2.0_Hw/BusAdator_Hw.ioc

Mcu.UserName=STM32F765VGHx
PA13.Signal=SYS_JTMS-SWDIO
PA14.Signal=SYS_JTCK-SWCLK
PA3.Signal=USB_OTG_HS_ULPI_D0
PA5.Signal=USB_OTG_HS_ULPI_CK
PB0.Signal=USB_OTG_HS_ULPI_D1
PB1.Signal=USB_OTG_HS_ULPI_D2
PB10.Signal=USB_OTG_HS_ULPI_D3
PB11.Signal=USB_OTG_HS_ULPI_D4
PB12.Signal=USB_OTG_HS_ULPI_D5
PB13.Signal=USB_OTG_HS_ULPI_D6
PB5.Signal=USB_OTG_HS_ULPI_D7
PB8.Signal=CAN1_RX
PB9.Signal=CAN1_TX
PC0.Signal=USB_OTG_HS_ULPI_STP
PC13.Signal=GPIO_Output
PC14/OSC32_IN.Signal=GPIO_Output
PC15/OSC32_OUT.Signal=GPXTI15
PC2.Signal=USB_OTG_HS_ULPI_DIR
PC3.Signal=USB_OTG_HS_ULPI_NXT
PD1.Signal=GPIO_Output
PD11.Signal=GPIO_Output
PE0.Signal=GPIO_Output
PE1.Signal=GPIO_Output
PE2.Signal=SPI4_SCK
PE3.Signal=GPIO_Output
PE4.Signal=GPIO_Output
PE5.Signal=SPI4_MISO
PE6.Signal=SPI4_MOSI
PH0/OSC_IN.Signal=RCC_OSC_IN
PH1/OSC_OUT.Signal=RCC_OSC_OUT
