OuyangJunyuan/Bus_Adaptor-PCB/BusAdaptor_v2.0/Bus_Adaptor_Sw/STM32/BusAdator_v2.0_Hw/UserFile/Thread/gui_thread.c

#include "gui_thread.h"

/* ---- 包含HAL.h ---- */
#include "usbd_cdc_if.h"
#include "tim.h"
/* ---- 包含ROTS.h ---- */
#include "FreeRTOS.h"
#include "task.h"
/* ---- 包含GUI ---- */
#include "lvgl.h"
/* ---- 包含用户文件 ---- */
#include "decode.h"
#include "math.h"
#include "page_manager.h"
/* ---- 全局变量声明 ---- */
uint32_t cntst;

/* ---- 私有变量声明 ---- */








/* ---- 任务声明 ---- */
static TaskHandle_t gui_thread_Handle, gui_tick_thread_Handle;
static void gui_thread(void *argument);
static void gui_tick_thread(void *argument);
void gui_thread_creat(void) {
	AppWindows_Init();
	AppWindows_ChangeTo(0);
	HAL_TIM_Base_Start_IT(&htim6);
	BaseType_t xReturn = pdPASS;
	xReturn = xTaskCreate((TaskFunction_t) gui_tick_thread,
			(const char*) "ticks", (uint16_t) 2048, (void*) NULL,
			(UBaseType_t) 1,
			(TaskHandle_t*) &gui_tick_thread_Handle);
	if (xReturn == pdPASS)
		;
	else
		while (1)
			;

	xReturn = xTaskCreate((TaskFunction_t) gui_thread,
			(const char*) "gui", (uint16_t) 2048, (void*) NULL,
			(UBaseType_t) 2,
			(TaskHandle_t*) &gui_thread_Handle);
	if (xReturn == pdPASS)
		;
	else
		while (1)
			;
}


/* ---- 任务内容 ---- */

static void gui_thread(void *argument) {
	/* ---- 线程初始化 ---- */

	uint32_t cnt = 0;
	/* ---- 线程初始化 ---- */
	for (;;) {
		vTaskDelay(30);
		cnt++;
		if ((cnt%50)==0){
			HAL_GPIO_TogglePin(GPIOD, GPIO_PIN_11);
		}
		if((cnt<300))
			AppWindows_ChangeTo(0);
		else if(cnt >300)
			AppWindows_ChangeTo(1);
		if(cnt==600)
			cnt=0;
		AppWindows_Running();
	}
}
static void gui_tick_thread(void *argument) {
	/* ---- 线程初始化 ---- */

	/* ---- 线程初始化 ---- */
	for (;;) {
		vTaskDelay(10);
	    //为lvgl提供心跳
	    lv_tick_inc(10);
	    //在任务中调用lv_task_handle()需要把任务对战开大一点，否则可能进入hard_fault。
	    lv_task_handler();
	}
}
