OuyangJunyuan/Bus_Adaptor-PCB/(commit log)

2020-06-06 总线适配器完结上传
    [BusAdaptor.PcbLib, BusAdaptor.SchDoc, BusAdaptor.SchLib, Bus_Adaptor_Hw.PrjPcb, Bus_Adaptor_Hw.xls, Pick Place for BusAdaptor_final.csv]
2020-09-11 提交了两个版本的文档
    [ALSRobot-QFN16 3x3.STEP, BusAdaptor.PcbLib, BusAdaptor.SchDoc, BusAdaptor.SchLib, Bus_Adaptor_Hw.PrjPcb, Bus_Adaptor_Hw.xls, CMT-8503-85B-SMT-TR.stl, CMT-8503-85B-SMT-TR.stp]
2020-09-12 完成CPU信息显示调度
2020-09-12 完成第二版代码编写后进行第一次归档整理
    [282838p.obj, ALSRobot-QFN16 3x3.STEP, BOM_NRF24L01PA-MINI_2020-04-24_02-19-52.csv, BusAdaptor.PcbLib, BusAdaptor.SchDoc, BusAdaptor.SchLib, Bus_Adaptor_Hw-v2.PrjPcb, Bus_Adaptor_Hw-v2.SchDoc]
